Xylons/TFG_Francisco_de_la_Mata/README.md

# TFG_Francisco_de_la_Mata

Para ejecutar el insole-dashboard : ng serve

Para ejecutar el backend :  npm run start
