Xylons/TFG_Francisco_de_la_Mata/Proyecto_Android_low_powered_BLE_MAmIoT/Consumo/PCBV1/README.txt

PSOC Creator Configuration:

NOTE:Be careful with Time Scale.

VDD VDDR: 2.5V
Debug Select: GPIO
Heap:0x80
Stack Size 0x0800

Clocks:
IMO: 32Mhz
