Xylons/TFG_Francisco_de_la_Mata/Proyecto_Android_low_powered_BLE_MAmIoT/Notas.txt

Medir consumo/carga con INA
Volver a probar posibles interferencias.

Añadir diodo protector batería.
Cambiar fuente lineal por conmutada.
Buscar otro controlador batería.

Algoritmo de calibración.
