Xylons/TFG_Francisco_de_la_Mata/backend/images/admin-1592569588191.jpeg

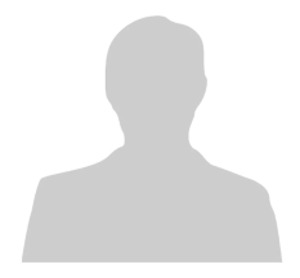
backend/images/admin-1592569588191.jpeg
