Xylons/TFG_Francisco_de_la_Mata/backend/images/marta-1599320887836.png

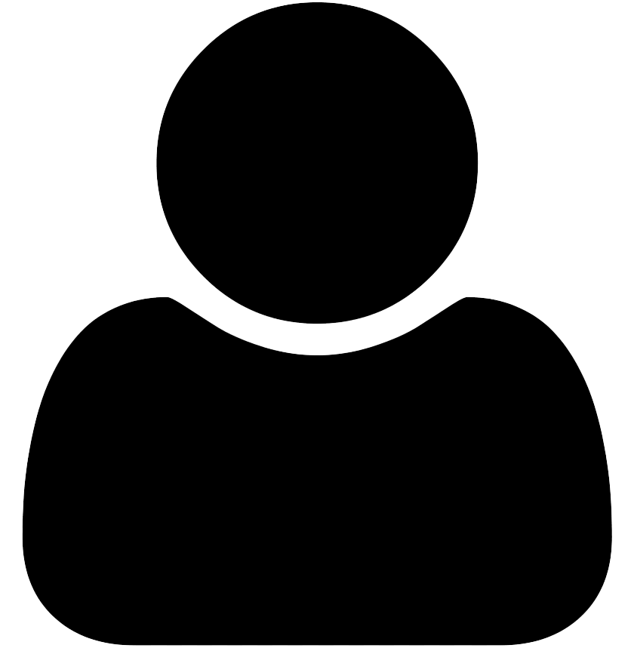
backend/images/marta-1599320887836.png
