Xylons/TFG_Francisco_de_la_Mata/backend/images/patient1-1595259013995.png

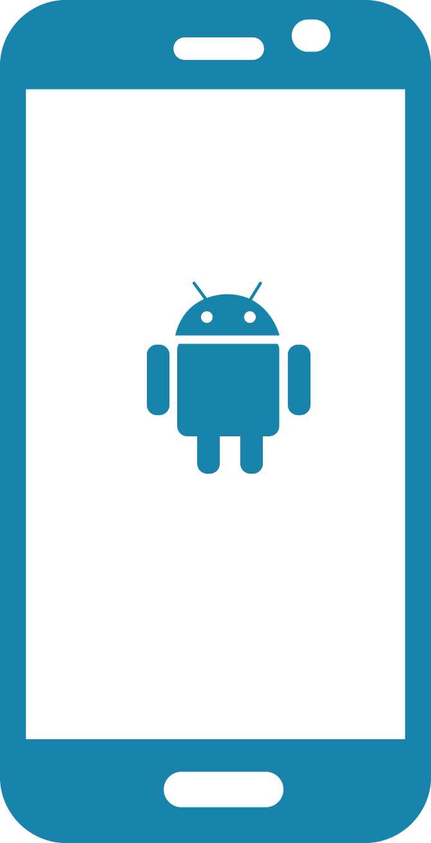
backend/images/patient1-1595259013995.png
