Xylons/TFG_Francisco_de_la_Mata/backend/images/saaaa-1586532342744.png

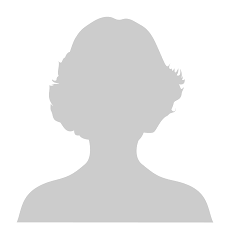
backend/images/saaaa-1586532342744.png
