Xylons/TFG_Francisco_de_la_Mata/Proyecto_Android_low_powered_BLE_MAmIoT/Consumo/Patrones/2.bmp

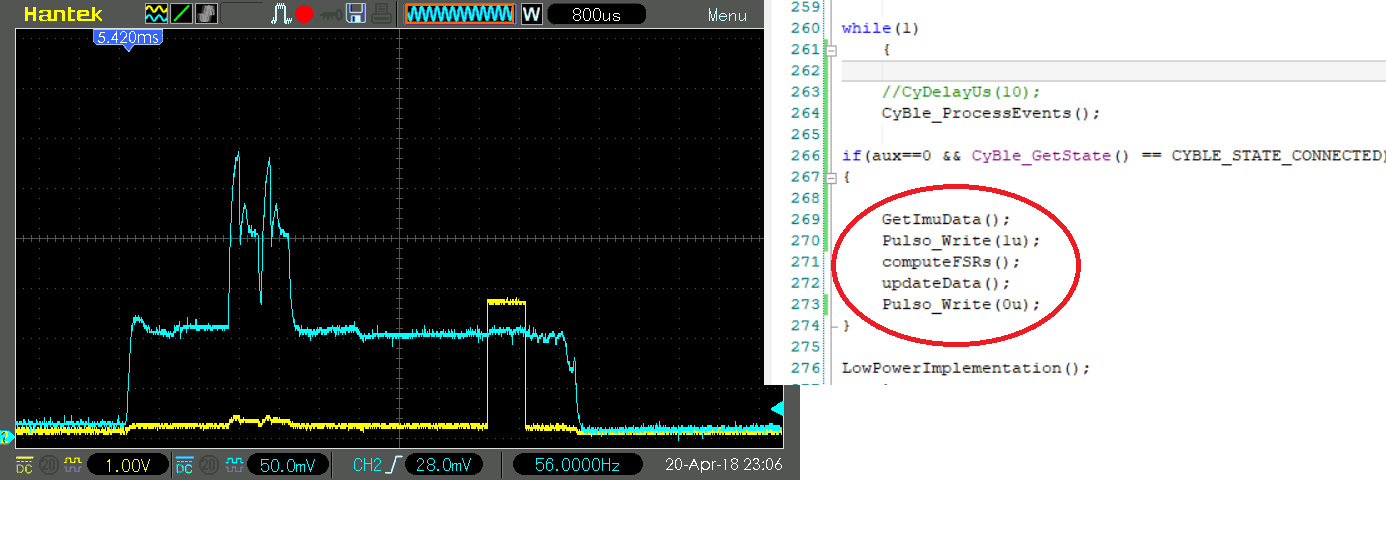
Proyecto_Android_low_powered_BLE_MAmIoT/Consumo/Patrones/2.bmp
