Xylons/TFG_Francisco_de_la_Mata/Proyecto_Android_low_powered_BLE_MAmIoT/Consumo/PCBV1/30Mhz/Low.bmp

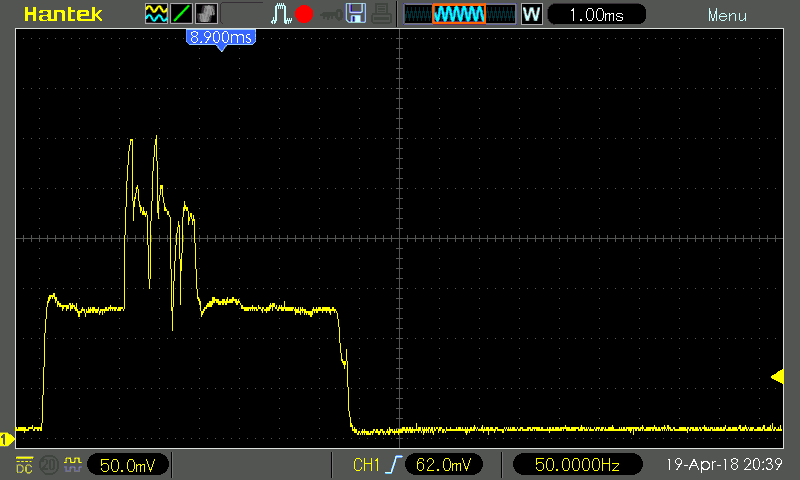
Proyecto_Android_low_powered_BLE_MAmIoT/Consumo/PCBV1/30Mhz/Low.bmp
