Xylons/TFG_Francisco_de_la_Mata/Proyecto_Android_low_powered_BLE_MAmIoT/Esquemas/updateInsole.png

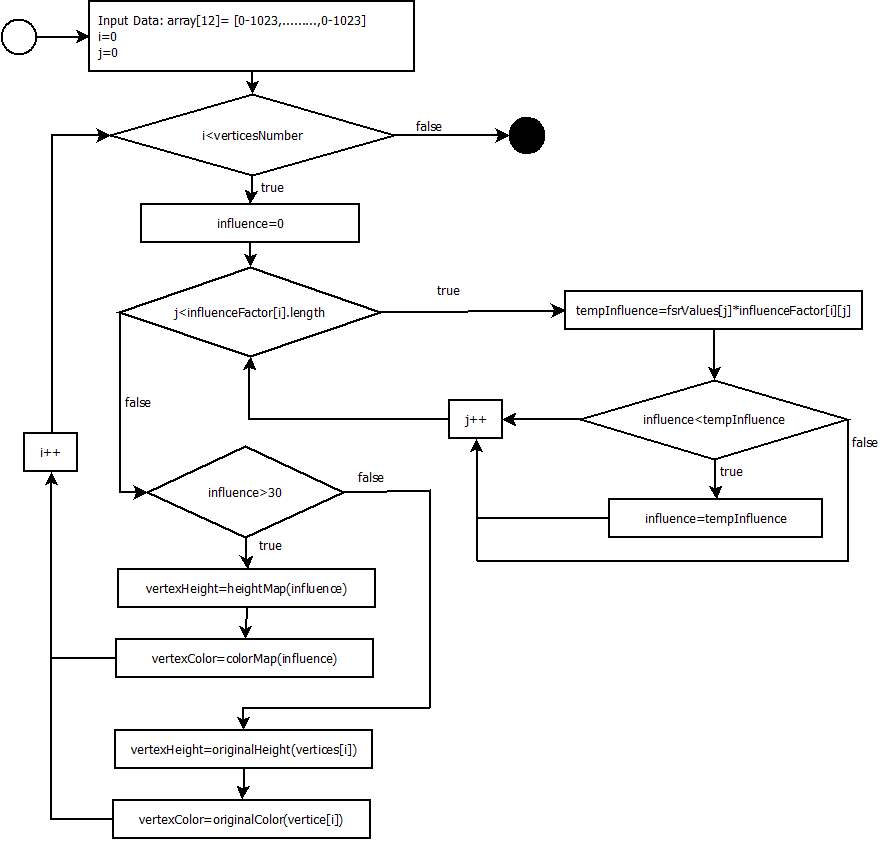
Proyecto_Android_low_powered_BLE_MAmIoT/Esquemas/updateInsole.png
