Xylons/TFG_Francisco_de_la_Mata/Proyecto_Android_low_powered_BLE_MAmIoT/FreeCad/Imagenes/parametros_configurables_lateral.png

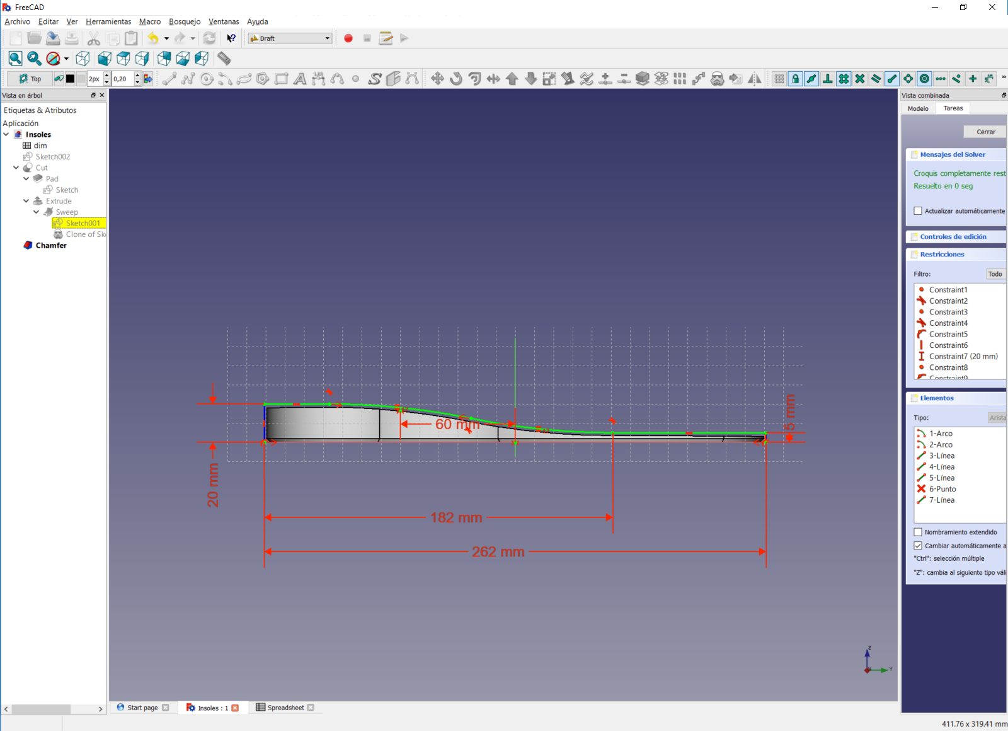
Proyecto_Android_low_powered_BLE_MAmIoT/FreeCad/Imagenes/parametros_configurables_lateral.png
