Xylons/TFG_Francisco_de_la_Mata/Proyecto_Android_low_powered_BLE_MAmIoT/FreeCad/Imagenes/plantilla_izq_y_drch.png

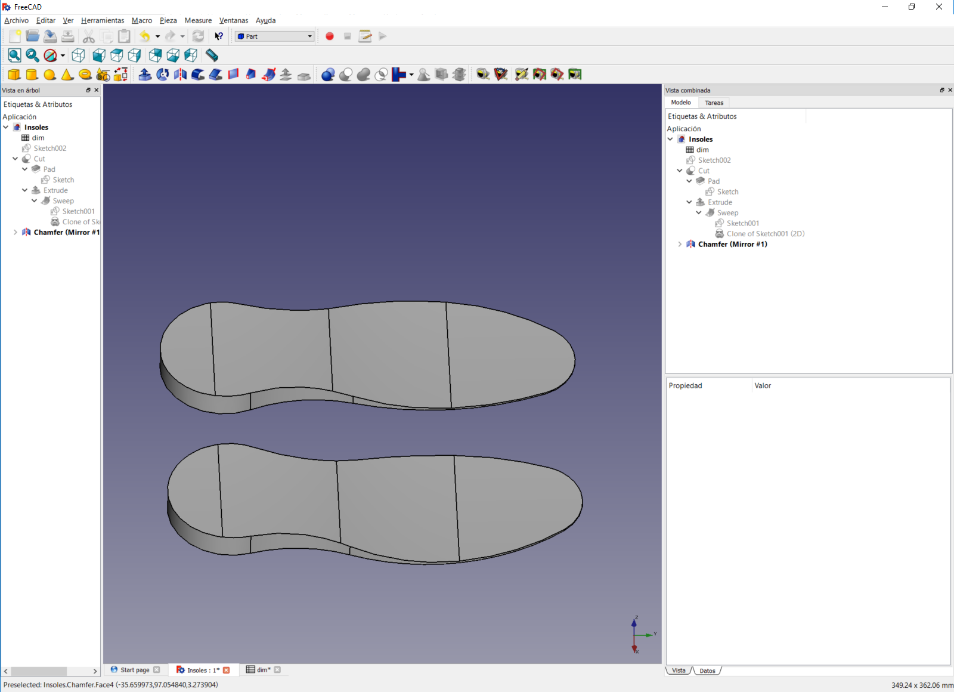
Proyecto_Android_low_powered_BLE_MAmIoT/FreeCad/Imagenes/plantilla_izq_y_drch.png
