Xylons/TFG_Francisco_de_la_Mata/Proyecto_Android_low_powered_BLE_MAmIoT/KiCad/Doc/FPC_Dimensions.jpg

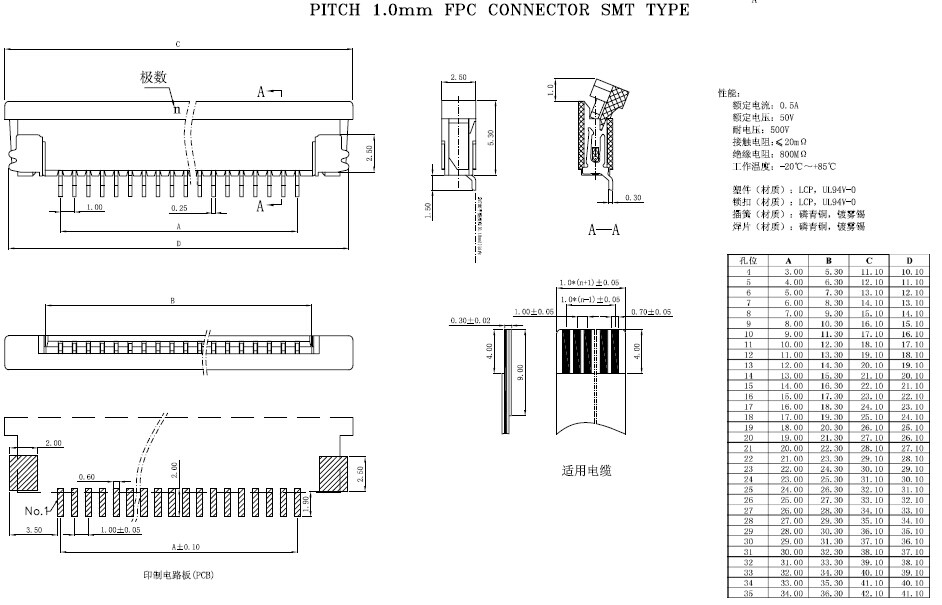
Proyecto_Android_low_powered_BLE_MAmIoT/KiCad/Doc/FPC_Dimensions.jpg
