Xylons/TFG_Francisco_de_la_Mata/Proyecto_Android_low_powered_BLE_MAmIoT/KiCad/Doc/MAmIoT_PCB.jpg

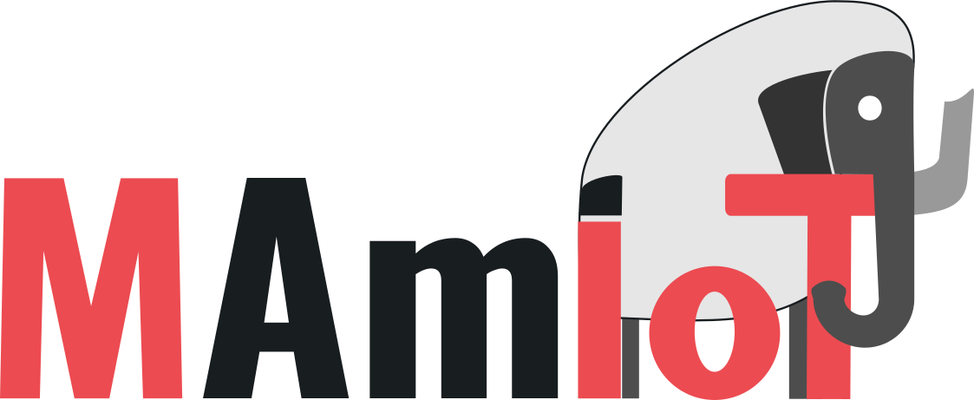
Proyecto_Android_low_powered_BLE_MAmIoT/KiCad/Doc/MAmIoT_PCB.jpg
