Xylons/TFG_Francisco_de_la_Mata/Proyecto_Android_low_powered_BLE_MAmIoT/KiCad/Insole_All_in_One/usb charger.png

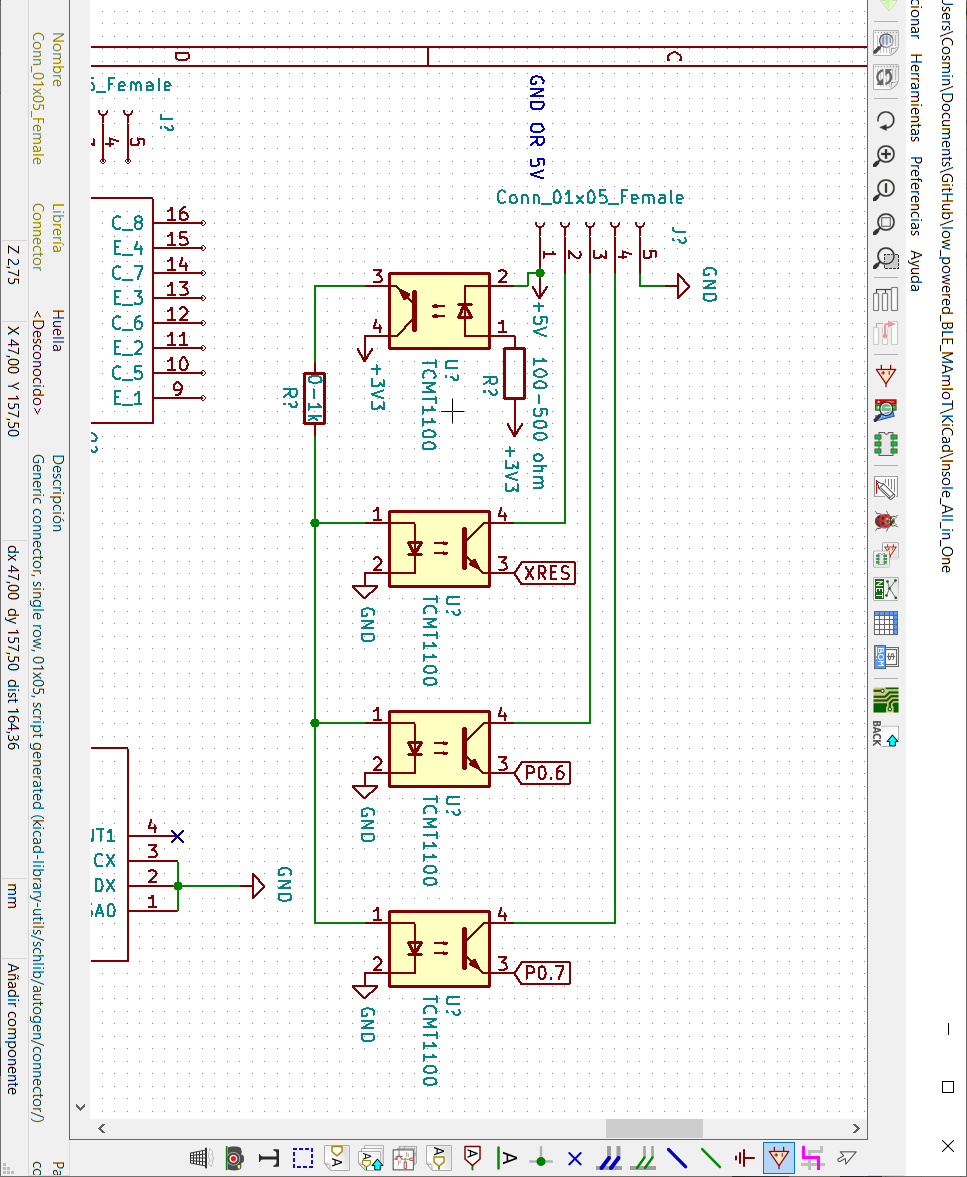
Proyecto_Android_low_powered_BLE_MAmIoT/KiCad/Insole_All_in_One/usb charger.png
