Xylons/TFG_Francisco_de_la_Mata/Proyecto_Android_low_powered_BLE_MAmIoT/KiCad/Doc/componentes_mejorados.txt

Fuente conmutada:
https://www.mouser.es/Semiconductors/Integrated-Circuits-ICs/Power-Management-ICs/Voltage-Regulators-Voltage-Controllers/Switching-Voltage-Regulators/_/N-6j76f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|0&No=25&P=1z0wa91Z1z0w87sZ1z0wcoiZ1z0w7yaZ1z0wbbzZ1z0w2k1Z1z0wcdhZ1z0wa2kZ1yzu4lsZ1z0z7ptZ1z0vne2Z1yutxogZ1yutx49Z1yxwtg1Z1z0vndnZ1y95l6b

Controladores de carga de bateria:
https://www.mouser.es/Semiconductors/Integrated-Circuits-ICs/Power-Management-ICs/Battery-Management/_/N-6j76v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

150mA : https://www.mouser.es/datasheet/2/277/MP2603_r1.01-371747.pdf
