Xylons/TFG_Francisco_de_la_Mata/Proyecto_Android_low_powered_BLE_MAmIoT/3DDesign/PiezoCeramicos/superior.stl

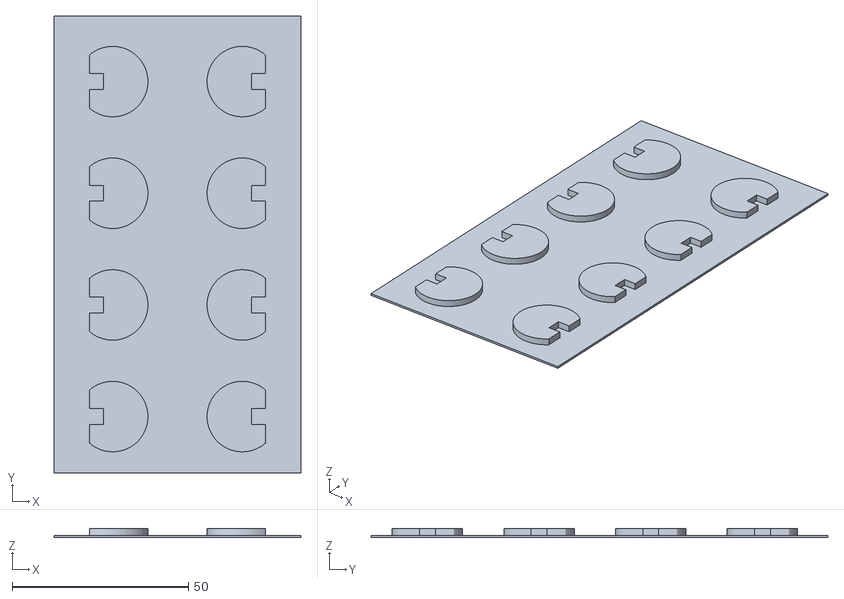
[picture p33: CAD file, 2020-07-15]
Proyecto_Android_low_powered_BLE_MAmIoT/3DDesign/PiezoCeramicos/superior.stl
70.0 x 129.6 x 2.60
