Xylons/TFG_Francisco_de_la_Mata/Proyecto_Android_low_powered_BLE_MAmIoT/3DDesign/suport.stl

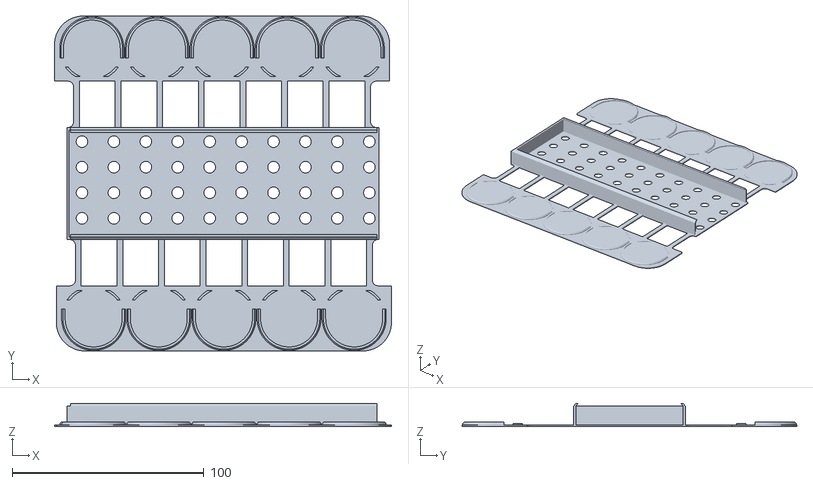
[picture p34: CAD file, 2020-07-15]
Proyecto_Android_low_powered_BLE_MAmIoT/3DDesign/suport.stl
176.0 x 174.9 x 12.2
