Xylons/TFG_Francisco_de_la_Mata/Proyecto_Android_low_powered_BLE_MAmIoT/FreeCad/FSRs/Parametric_square_fsr.FCStd

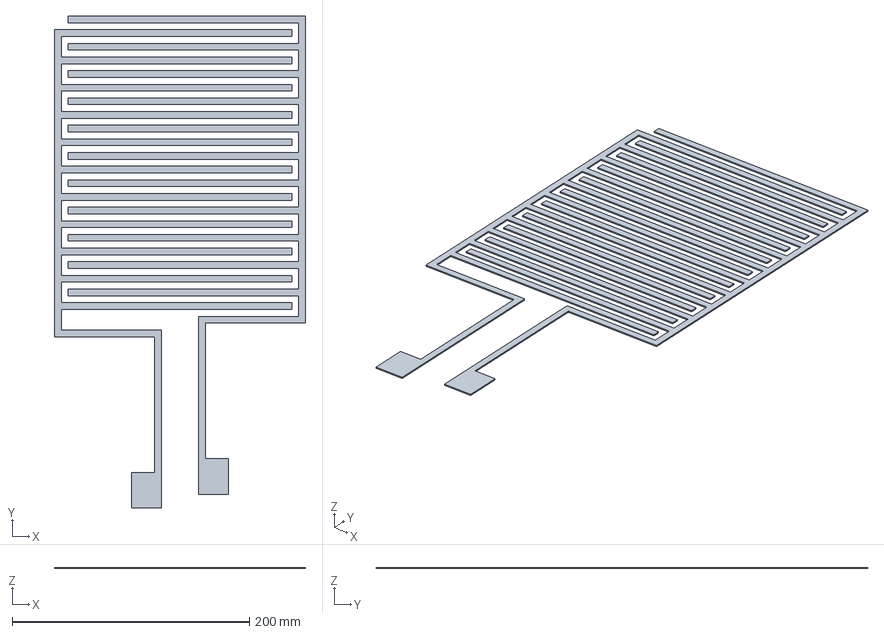
[picture p35: CAD file, 2020-07-15]
Proyecto_Android_low_powered_BLE_MAmIoT/FreeCad/FSRs/Parametric_square_fsr.FCStd
211.5 x 414.5 x 1.00 mm
