Xylons/TFG_Francisco_de_la_Mata/Proyecto_Android_low_powered_BLE_MAmIoT/FreeCad/InsoleV2/Parte_Inferior_derecha.stl

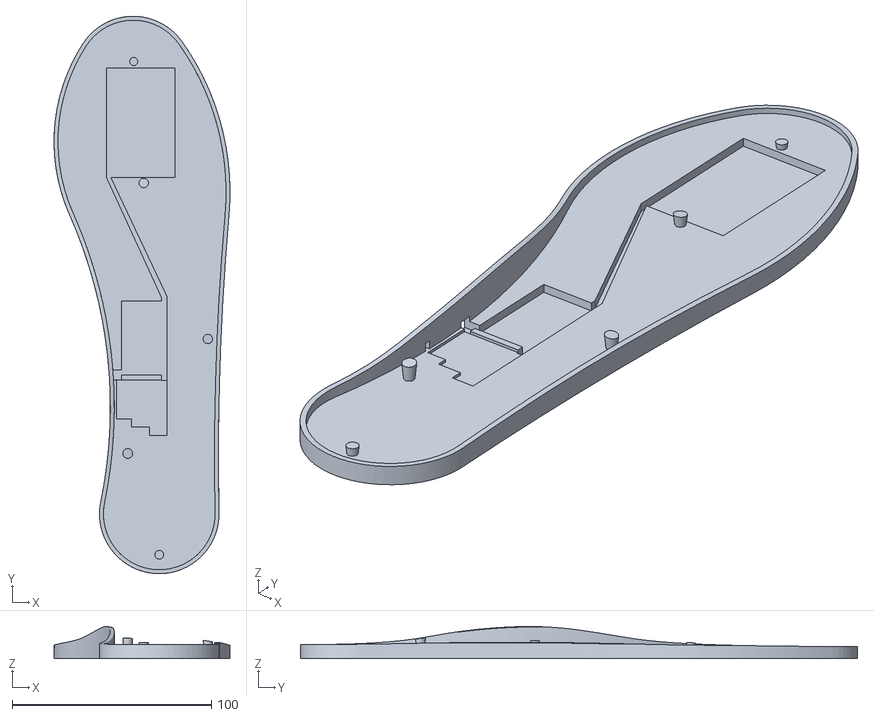
[picture p36: CAD file, 2020-07-15]
Proyecto_Android_low_powered_BLE_MAmIoT/FreeCad/InsoleV2/Parte_Inferior_derecha.stl
88.3 x 279.6 x 16.1
