Xylons/TFG_Francisco_de_la_Mata/Proyecto_Android_low_powered_BLE_MAmIoT/KiCad/Insole_All_in_One/plantillas/plantilla34.stl

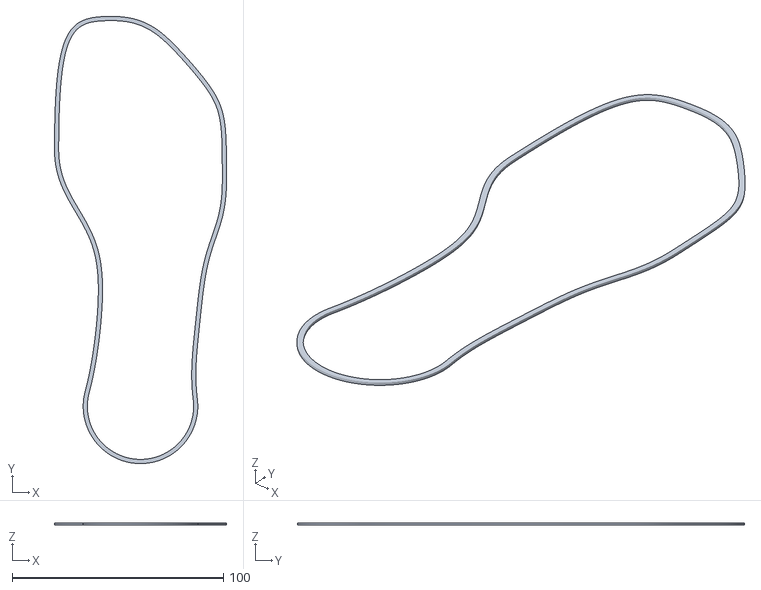
[picture p37: CAD file, 2020-07-15]
Proyecto_Android_low_powered_BLE_MAmIoT/KiCad/Insole_All_in_One/plantillas/plantilla34.stl
81.4 x 211.7 x 1.00
