Xylons/TFG_Francisco_de_la_Mata/Proyecto_Android_low_powered_BLE_MAmIoT/KiCad/Insole_All_in_One_43/plantillas/plantilla34_offset.dxf

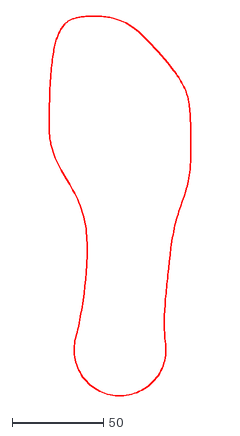
[picture p38: CAD file, 2020-07-15]
Proyecto_Android_low_powered_BLE_MAmIoT/KiCad/Insole_All_in_One_43/plantillas/plantilla34_offset.dxf
77.4 x 207.7
