Xylons/TFG_Francisco_de_la_Mata/Proyecto_Android_low_powered_BLE_MAmIoT/KiCad/Insole_flex_left_32_sensors_right/fabrication/Insole_flex_32s-Edge.Cuts.dxf

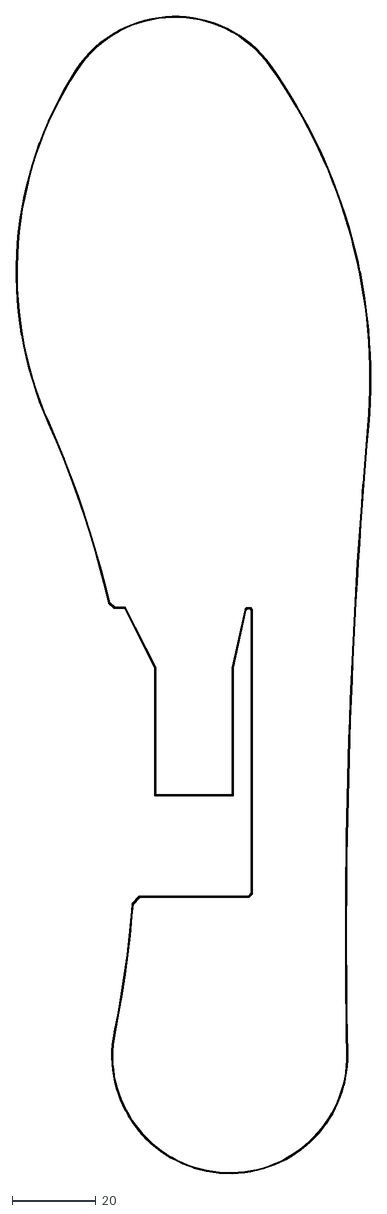
[picture p39: CAD file, 2020-07-15]
Proyecto_Android_low_powered_BLE_MAmIoT/KiCad/Insole_flex_left_32_sensors_right/fabrication/Insole_flex_32s-Edge.Cuts.dxf
84.5 x 275.8
