Xylons/TFG_Francisco_de_la_Mata/Proyecto_Android_low_powered_BLE_MAmIoT/KiCad/Insole_PCB_production_32_sensors/fabrication/fabricacion_dxf/Insole_PCB-F.Cu.dxf

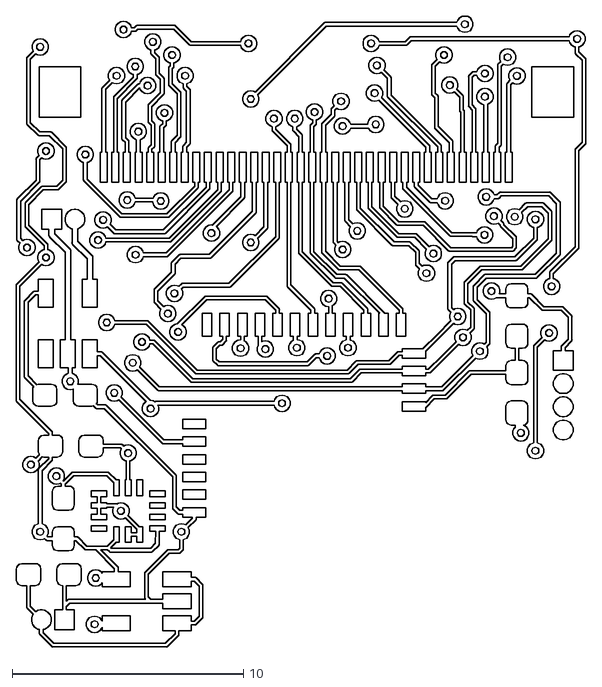
[picture p40: CAD file, 2020-07-15]
Proyecto_Android_low_powered_BLE_MAmIoT/KiCad/Insole_PCB_production_32_sensors/fabrication/fabricacion_dxf/Insole_PCB-F.Cu.dxf
24.6 x 27.3
