Xylons/TFG_Francisco_de_la_Mata/Proyecto_Android_low_powered_BLE_MAmIoT/KiCad/Prototypes_06_01_2020/Insole_All_in_One_37/plantillas/plantilla43_exterior.dxf

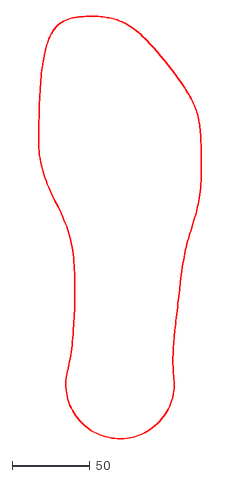
[picture p41: CAD file, 2020-07-15]
Proyecto_Android_low_powered_BLE_MAmIoT/KiCad/Prototypes_06_01_2020/Insole_All_in_One_37/plantillas/plantilla43_exterior.dxf
104.5 x 271.7
