Xylons/TFG_Francisco_de_la_Mata/Proyecto_Android_low_powered_BLE_MAmIoT/KiCad/Prototypes_06_01_2020/Insole_All_in_One_38/plantillas/insole43.stl

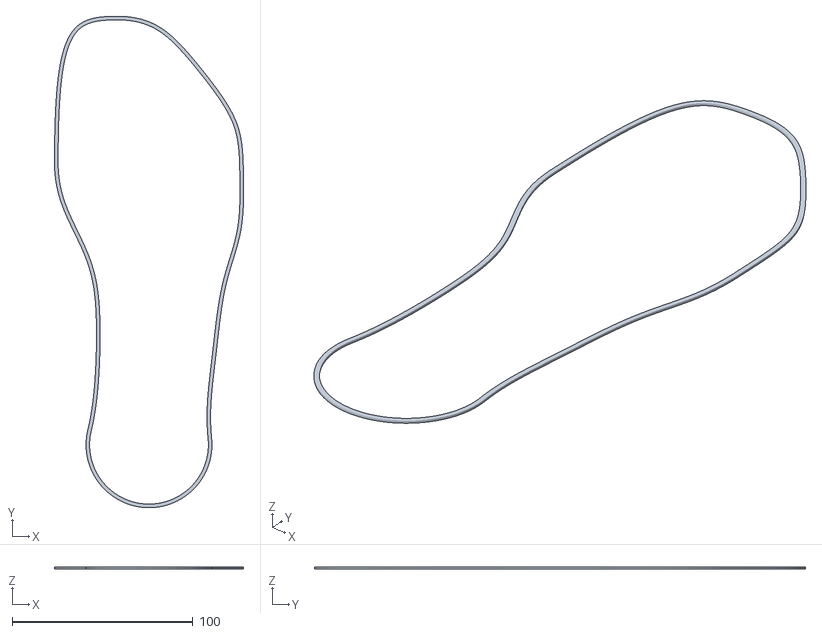
[picture p42: CAD file, 2020-07-15]
Proyecto_Android_low_powered_BLE_MAmIoT/KiCad/Prototypes_06_01_2020/Insole_All_in_One_38/plantillas/insole43.stl
104.5 x 271.7 x 1.00
