Xylons/TFG_Francisco_de_la_Mata/Proyecto_Android_low_powered_BLE_MAmIoT/KiCad/Prototypes_06_01_2020/Insole_All_in_One_43/plantillas/plantilla43_interior.dxf

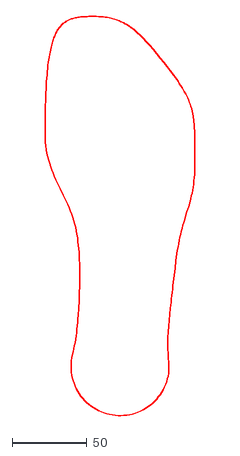
[picture p43: CAD file, 2020-07-15]
Proyecto_Android_low_powered_BLE_MAmIoT/KiCad/Prototypes_06_01_2020/Insole_All_in_One_43/plantillas/plantilla43_interior.dxf
100.5 x 267.7
