Xylons/TFG_Francisco_de_la_Mata/Proyecto_Android_low_powered_BLE_MAmIoT/KiCad/Prototypes_06_01_2020/Modelo_Plantilla40_Interior.dxf

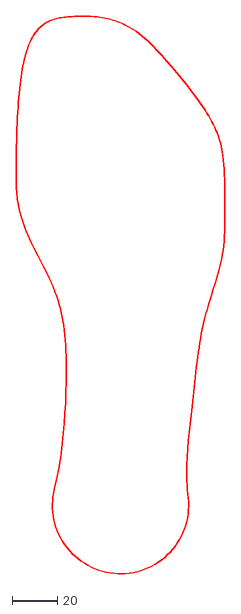
[picture p44: CAD file, 2020-07-15]
Proyecto_Android_low_powered_BLE_MAmIoT/KiCad/Prototypes_06_01_2020/Modelo_Plantilla40_Interior.dxf
92.8 x 247.7
