Xylons/TFG_Francisco_de_la_Mata/Proyecto_Android_low_powered_BLE_MAmIoT/FreeCad/FSRs/montaje.FCStd

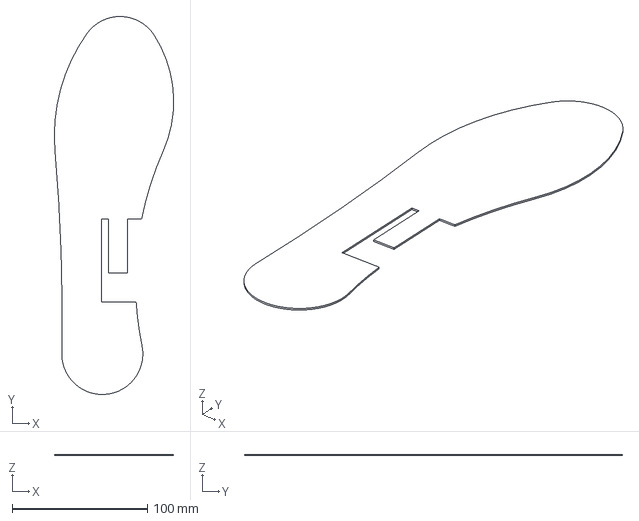
[picture p46: CAD file, 2020-07-15]
Proyecto_Android_low_powered_BLE_MAmIoT/FreeCad/FSRs/montaje.FCStd
88.3 x 279.6 x 1.00 mm
