Xylons/TFG_Francisco_de_la_Mata/Proyecto_Android_low_powered_BLE_MAmIoT/FreeCad/InsoleV2/tapa_carga_inalambrica_derecha.stl

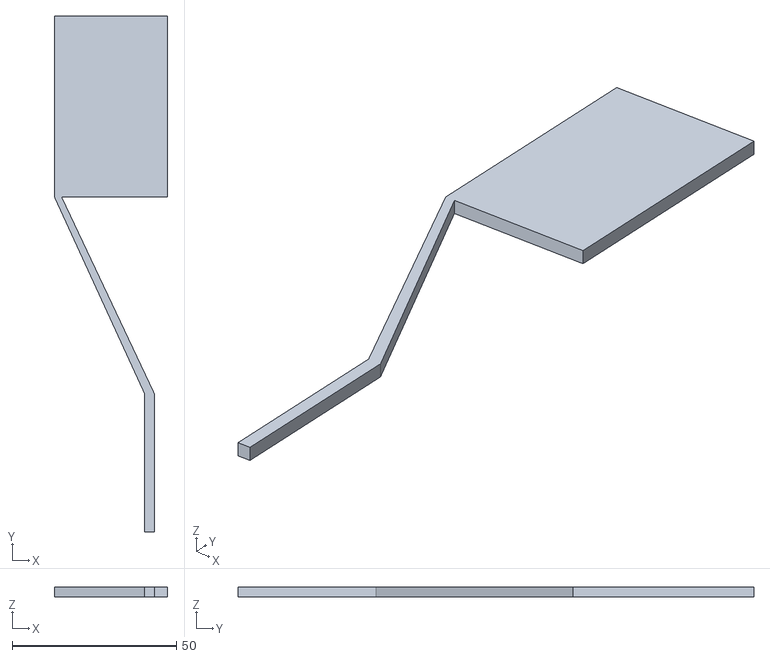
[picture p47: CAD file, 2020-07-15]
Proyecto_Android_low_powered_BLE_MAmIoT/FreeCad/InsoleV2/tapa_carga_inalambrica_derecha.stl
34.5 x 157.0 x 3.00
