Xylons/TFG_Francisco_de_la_Mata/Proyecto_Android_low_powered_BLE_MAmIoT/KiCad/Insole_PCB_production_32_sensors/fabrication/fabricacion_dxf/Insole_PCB-Edge.Cuts.dxf

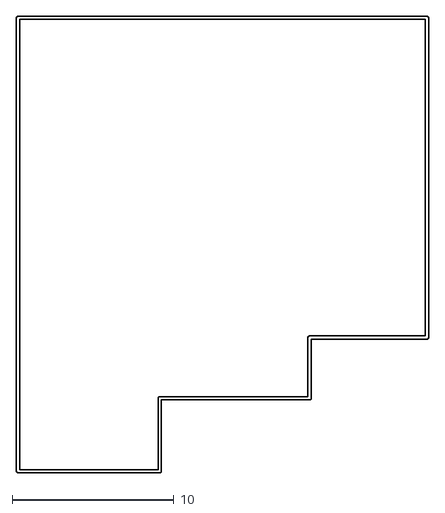
[picture p48: CAD file, 2020-07-15]
Proyecto_Android_low_powered_BLE_MAmIoT/KiCad/Insole_PCB_production_32_sensors/fabrication/fabricacion_dxf/Insole_PCB-Edge.Cuts.dxf
25.4 x 28.2
