Xylons/TFG_Francisco_de_la_Mata/Proyecto_Android_low_powered_BLE_MAmIoT/KiCad/Prototypes_06_01_2020/Modelo_Plantilla36.stl

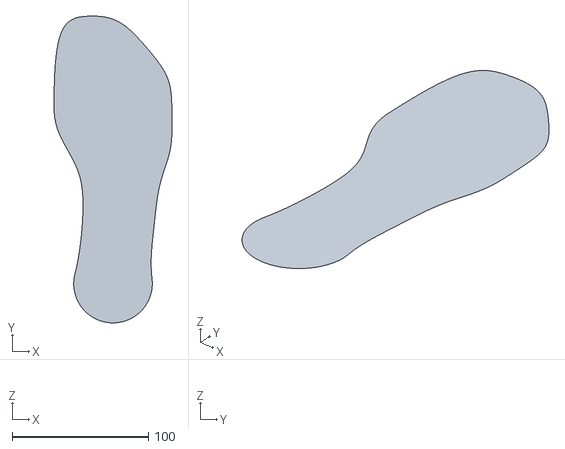
[picture p49: CAD file, 2020-07-15]
Proyecto_Android_low_powered_BLE_MAmIoT/KiCad/Prototypes_06_01_2020/Modelo_Plantilla36.stl
86.5 x 225.0 x 0
