Xylons/TFG_Francisco_de_la_Mata/Proyecto_Android_low_powered_BLE_MAmIoT/3DDesign/PiezoCeramicos/inferior.stl

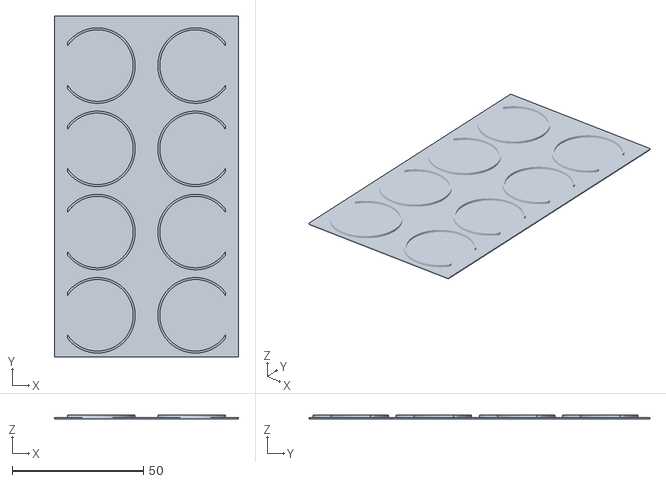
[picture p50: CAD file, 2020-07-15]
Proyecto_Android_low_powered_BLE_MAmIoT/3DDesign/PiezoCeramicos/inferior.stl
70.0 x 129.6 x 1.60
