Xylons/TFG_Francisco_de_la_Mata/Proyecto_Android_low_powered_BLE_MAmIoT/FreeCad/InsoleV2/Insole_protect_QI_Charge.FCStd

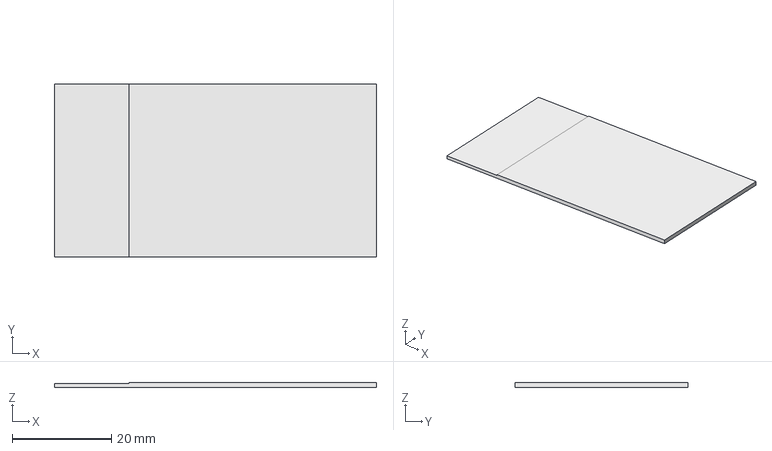
[picture p51: CAD file, 2020-07-15]
Proyecto_Android_low_powered_BLE_MAmIoT/FreeCad/InsoleV2/Insole_protect_QI_Charge.FCStd
65.0 x 35.0 x 1.00 mm
