Xylons/TFG_Francisco_de_la_Mata/Proyecto_Android_low_powered_BLE_MAmIoT/KiCad/Insole_PCB_production_32_sensors/fabrication/fabricacion_dxf/Insole_PCB-B.Cu.dxf

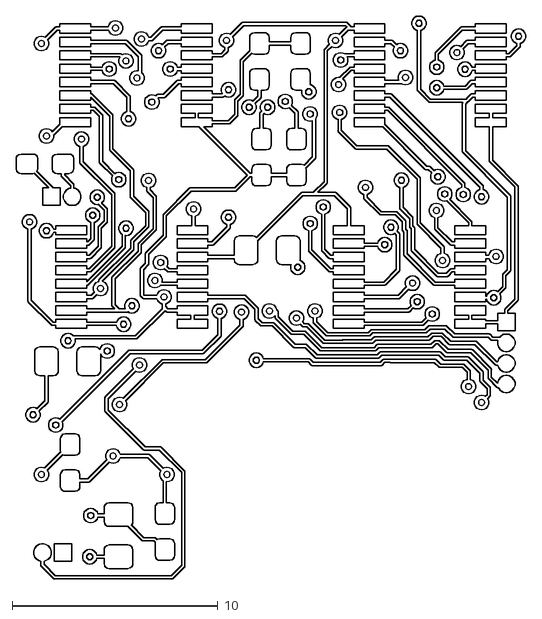
[picture p52: CAD file, 2020-07-15]
Proyecto_Android_low_powered_BLE_MAmIoT/KiCad/Insole_PCB_production_32_sensors/fabrication/fabricacion_dxf/Insole_PCB-B.Cu.dxf
24.8 x 27.4
