Xylons/TFG_Francisco_de_la_Mata/Proyecto_Android_low_powered_BLE_MAmIoT/KiCad/Prototypes_06_01_2020/Modelo_Plantilla38_Interior.dxf

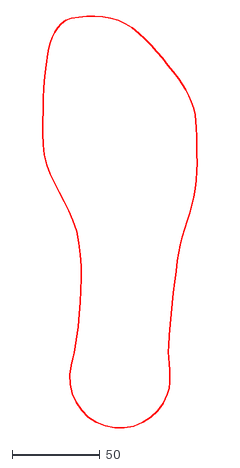
[picture p53: CAD file, 2020-07-15]
Proyecto_Android_low_powered_BLE_MAmIoT/KiCad/Prototypes_06_01_2020/Modelo_Plantilla38_Interior.dxf
87.7 x 234.3
