Xylons/TFG_Francisco_de_la_Mata/Proyecto_Android_low_powered_BLE_MAmIoT/KiCad/Prototypes_06_01_2020/Modelo_Plantilla40_Exterior.dxf

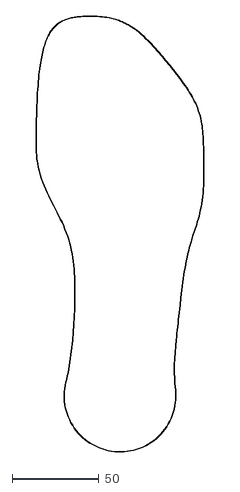
[picture p54: CAD file, 2020-07-15]
Proyecto_Android_low_powered_BLE_MAmIoT/KiCad/Prototypes_06_01_2020/Modelo_Plantilla40_Exterior.dxf
96.8 x 251.7
