Xylons/TFG_Francisco_de_la_Mata/Proyecto_Android_low_powered_BLE_MAmIoT/FreeCad/InsoleV2/Parte_Superior.stl

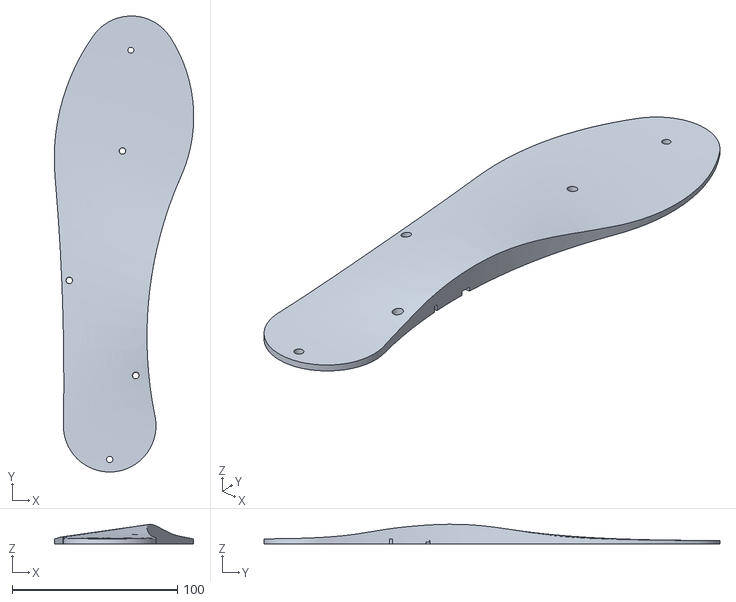
[picture p55: CAD file, 2020-07-15]
Proyecto_Android_low_powered_BLE_MAmIoT/FreeCad/InsoleV2/Parte_Superior.stl
84.3 x 275.6 x 11.8
