Xylons/TFG_Francisco_de_la_Mata/Proyecto_Android_low_powered_BLE_MAmIoT/FreeCad/InsoleV2/Insoles.FCStd

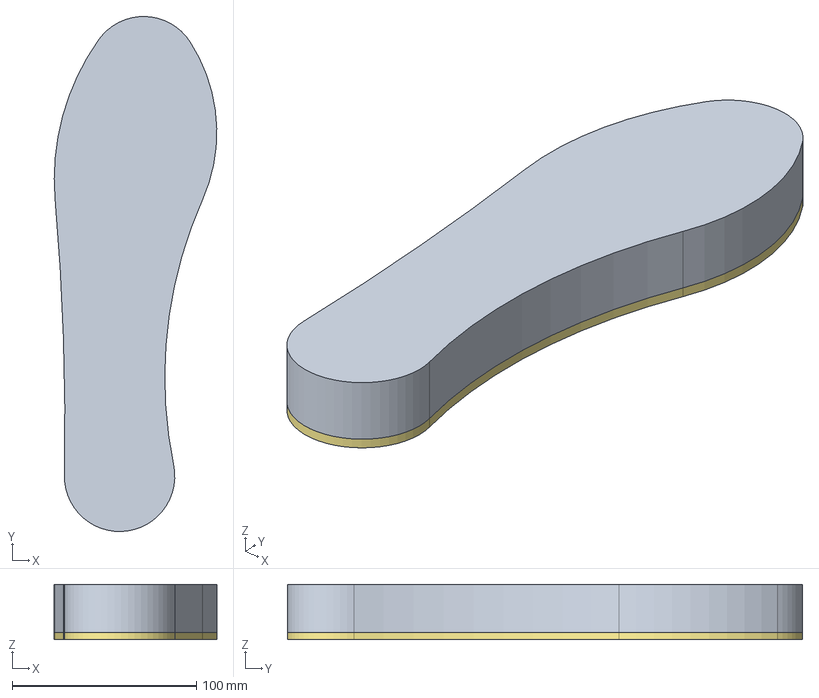
[picture p57: CAD file, 2020-07-15]
Proyecto_Android_low_powered_BLE_MAmIoT/FreeCad/InsoleV2/Insoles.FCStd
88.3 x 279.6 x 30.0 mm
Body_Base3D
Body_Pirulo1
Body_Pirulo2
Body_Pirulo3
Body_Pirulo4
Body_Pirulo5
Parte_Inferior_Plantilla
Pad003Body
