Xylons/TFG_Francisco_de_la_Mata/(list of files, cad)

Other CAD files:
Proyecto_Android_low_powered_BLE_MAmIoT/FreeCad/pieza_filaflex/filaflex.FCStd
Proyecto_Android_low_powered_BLE_MAmIoT/FreeCad/test_PCB/test_1.FCStd
Proyecto_Android_low_powered_BLE_MAmIoT/3DDesign/sujecionFSR.FCStd
Proyecto_Android_low_powered_BLE_MAmIoT/FreeCad/InsoleV2/Parte_Inferior.stl
Proyecto_Android_low_powered_BLE_MAmIoT/FreeCad/InsoleV2/Parte_Superior_Derecha.stl
Proyecto_Android_low_powered_BLE_MAmIoT/FreeCad/InsoleV2/tapa_carga_inalambrica.stl
Proyecto_Android_low_powered_BLE_MAmIoT/Blender/insole_left.blend
Proyecto_Android_low_powered_BLE_MAmIoT/Blender/insole_left_surface.blend
Proyecto_Android_low_powered_BLE_MAmIoT/Blender/insole_right.blend
Proyecto_Android_low_powered_BLE_MAmIoT/Blender/insole_right_surface.blend
Proyecto_Android_low_powered_BLE_MAmIoT/FreeCad/InsoleV1/Insoles.FCStd
Proyecto_Android_low_powered_BLE_MAmIoT/FreeCad/InsoleV1/PCB_SUPPORT_PERIMETER.stl
Proyecto_Android_low_powered_BLE_MAmIoT/FreeCad/InsoleV1/PCB_SUPPORT_PERIMETERç.FCStd
Proyecto_Android_low_powered_BLE_MAmIoT/FreeCad/InsoleV1/PCB_Support_for_stencils.FCStd
Proyecto_Android_low_powered_BLE_MAmIoT/FreeCad/InsoleV1/PCB_Support_for_stencils.stl
Proyecto_Android_low_powered_BLE_MAmIoT/FreeCad/InsoleV1/Solder_Paste_card.FCStd
Proyecto_Android_low_powered_BLE_MAmIoT/FreeCad/InsoleV1/Solder_Paste_card.stl
Proyecto_Android_low_powered_BLE_MAmIoT/FreeCad/InsoleV1/insole_left.obj
Proyecto_Android_low_powered_BLE_MAmIoT/FreeCad/InsoleV1/insole_left.step
Proyecto_Android_low_powered_BLE_MAmIoT/FreeCad/InsoleV1/insole_left.stl
Proyecto_Android_low_powered_BLE_MAmIoT/FreeCad/InsoleV1/kicad-2mm.dxf
Proyecto_Android_low_powered_BLE_MAmIoT/FreeCad/InsoleV1/kicad.dxf
Proyecto_Android_low_powered_BLE_MAmIoT/FreeCad/InsoleV1/kicad_95.dxf
Proyecto_Android_low_powered_BLE_MAmIoT/FreeCad/InsoleV1/v1.0.stl
Proyecto_Android_low_powered_BLE_MAmIoT/InsoleV2/app/src/main/assets/derecha.blend
Proyecto_Android_low_powered_BLE_MAmIoT/InsoleV2/app/src/main/assets/derecha_superficie.blend
Proyecto_Android_low_powered_BLE_MAmIoT/InsoleV2/app/src/main/assets/izquierda.blend
Proyecto_Android_low_powered_BLE_MAmIoT/InsoleV2/app/src/main/assets/izquierda_surface.blend
Proyecto_Android_low_powered_BLE_MAmIoT/KiCad/Insole_All_in_One/plantillas/plantilla34.dxf
Proyecto_Android_low_powered_BLE_MAmIoT/KiCad/Insole_All_in_One_43/plantillas/plantilla34.dxf
Proyecto_Android_low_powered_BLE_MAmIoT/KiCad/Insole_All_in_One_43_Left/plantillas/plantilla34.dxf
Proyecto_Android_low_powered_BLE_MAmIoT/KiCad/Insole_All_in_One_43_Left_old_usb/plantillas/plantilla34.dxf
Proyecto_Android_low_powered_BLE_MAmIoT/KiCad/Insole_PCB_production_32_sensors/fabrication/fabricacion_dxf/Insole_PCB-B.Mask.dxf
Proyecto_Android_low_powered_BLE_MAmIoT/KiCad/Insole_PCB_production_32_sensors/fabrication/fabricacion_dxf/Insole_PCB-B.SilkS.dxf
Proyecto_Android_low_powered_BLE_MAmIoT/KiCad/Insole_PCB_production_32_sensors/fabrication/fabricacion_dxf/Insole_PCB-F.Mask.dxf
Proyecto_Android_low_powered_BLE_MAmIoT/KiCad/Insole_PCB_production_32_sensors/fabrication/fabricacion_dxf/Insole_PCB-F.SilkS.dxf
Proyecto_Android_low_powered_BLE_MAmIoT/KiCad/Insole_flex_left_32_sensors_right/fabrication/Insole_flex_32s-F.Mask.dxf
Proyecto_Android_low_powered_BLE_MAmIoT/KiCad/Prototypes_06_01_2020/Insole_All_in_One_36/plantillas/plantilla34.dxf
Proyecto_Android_low_powered_BLE_MAmIoT/KiCad/Prototypes_06_01_2020/Insole_All_in_One_36_LEFT/plantillas/plantilla34.dxf
Proyecto_Android_low_powered_BLE_MAmIoT/KiCad/Prototypes_06_01_2020/Insole_All_in_One_37/plantillas/plantilla34.dxf
Proyecto_Android_low_powered_BLE_MAmIoT/KiCad/Prototypes_06_01_2020/Insole_All_in_One_37_LEFT/plantillas/plantilla34.dxf
Proyecto_Android_low_powered_BLE_MAmIoT/KiCad/Prototypes_06_01_2020/Insole_All_in_One_38/plantillas/plantilla34.dxf
Proyecto_Android_low_powered_BLE_MAmIoT/KiCad/Prototypes_06_01_2020/Insole_All_in_One_38_LEFT/plantillas/plantilla34.dxf
Proyecto_Android_low_powered_BLE_MAmIoT/KiCad/Prototypes_06_01_2020/Insole_All_in_One_40/plantillas/plantilla34.dxf
Proyecto_Android_low_powered_BLE_MAmIoT/KiCad/Prototypes_06_01_2020/Insole_All_in_One_40_LEFT/plantillas/plantilla34.dxf
Proyecto_Android_low_powered_BLE_MAmIoT/KiCad/Prototypes_06_01_2020/Insole_All_in_One_43/plantillas/plantilla34.dxf
Proyecto_Android_low_powered_BLE_MAmIoT/KiCad/Prototypes_06_01_2020/Insole_All_in_One_43_LEFT/plantillas/plantilla34.dxf
Proyecto_Android_low_powered_BLE_MAmIoT/KiCad/Prototypes_06_01_2020/Modelo_Plantilla40.dxf
Proyecto_Android_low_powered_BLE_MAmIoT/KiCad/Prototypes_06_01_2020/OLD_29_01_2020_Left/Insole_All_in_One_36_LEFT/plantillas/plantilla34.dxf
Proyecto_Android_low_powered_BLE_MAmIoT/KiCad/Prototypes_06_01_2020/OLD_29_01_2020_Left/Insole_All_in_One_37_LEFT/plantillas/plantilla34.dxf
Proyecto_Android_low_powered_BLE_MAmIoT/KiCad/Prototypes_06_01_2020/OLD_29_01_2020_Left/Insole_All_in_One_38_LEFT/plantillas/plantilla34.dxf
Proyecto_Android_low_powered_BLE_MAmIoT/KiCad/Prototypes_06_01_2020/OLD_29_01_2020_Left/Insole_All_in_One_40_LEFT/plantillas/plantilla34.dxf
Proyecto_Android_low_powered_BLE_MAmIoT/KiCad/Prototypes_06_01_2020/OLD_29_01_2020_Left/Insole_All_in_One_43_LEFT/plantillas/plantilla34.dxf
Proyecto_Android_low_powered_BLE_MAmIoT/KiCad/Prototypes_06_01_2020/OLD_Left/Insole_All_in_One_36_Left/plantillas/plantilla34.dxf
Proyecto_Android_low_powered_BLE_MAmIoT/KiCad/Prototypes_06_01_2020/OLD_Left/Insole_All_in_One_37_Left/plantillas/plantilla34.dxf
Proyecto_Android_low_powered_BLE_MAmIoT/KiCad/Prototypes_06_01_2020/OLD_Left/Insole_All_in_One_38_Left/plantillas/plantilla34.dxf
Proyecto_Android_low_powered_BLE_MAmIoT/KiCad/Prototypes_06_01_2020/OLD_Left/Insole_All_in_One_40_Left/plantillas/plantilla34.dxf
Proyecto_Android_low_powered_BLE_MAmIoT/KiCad/Prototypes_06_01_2020/OLD_Left/Insole_All_in_One_43_Left/plantillas/plantilla34.dxf
