Xylons/TFG_Francisco_de_la_Mata/Proyecto_Android_low_powered_BLE_MAmIoT/Consumo/PCBV1_Firmware_Repaired/Measuring_BLE_Power_Consumption.xls

 | Battery capacity : | 250 | mAh
 | Frequency: | 50 | Hz
 | Deep Sleep Current | 0.2 | mA
 | Battery correction factor: | 0.8
 |  | 16MHz |  |  | 22MHz |  |  | 30MHz
 |  | Time (us) | Current (mA) | Time*Current | Time (us) | Current (mA) | Time*Current | Time (us) | Current (mA) | Time*Current
State 1 | wake-up | 1000 | 10 | 10000 | 1000 | 11 | 11000 | 1000 | 13.5 | 13500
State 2 | pre-processing | 1000 | 10 | 10000 | 1000 | 11 | 11000 | 1000 | 13.5 | 13500
State 3 | Rx | 180 | 26 | 4680 | 200 | 27 | 5400 | 400 | 29.5 | 11800
 |  | 100 | 21 | 2100 | 200 | 21.5 | 4300 | 200 | 24 | 4800
State 4 | Rx-to-Tx | 210 | 17 | 3570 | 300 | 18 | 5400 | 200 | 21 | 4200
State 5 | Tx | 190 | 24 | 4560 | 300 | 24.5 | 7350 | 200 | 28 | 5600
 |  | 400 | 20 | 8000 | 0 | 0 | 0 | 390 | 22 | 8580
State 6 | post-processing | 5600 | 9 | 50400 | 1000 | 14 | 14000 | 4400 | 13 | 57200
 |  | 1200 | 8 | 9600 | 4000 | 10 | 40000 | 200 | 5 | 1000
 |  | 0 | 0 | 0 | 0 | 0 | 0 | 0 | 0 | 0
State 7 | pre-sleep | 500 | 4 | 2000 | 1200 | 5 | 6000 | 0 | 0 | 0
 |  |  |  | 104910 |  |  | 104450 |  |  | 120180
 | Total event time | 10380 |  |  | 9200 |  |  | 7990
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
