Xylons/TFG_Francisco_de_la_Mata/Proyecto_Android_low_powered_BLE_MAmIoT/Esquemas/esquema_ahorro_energia.pdf

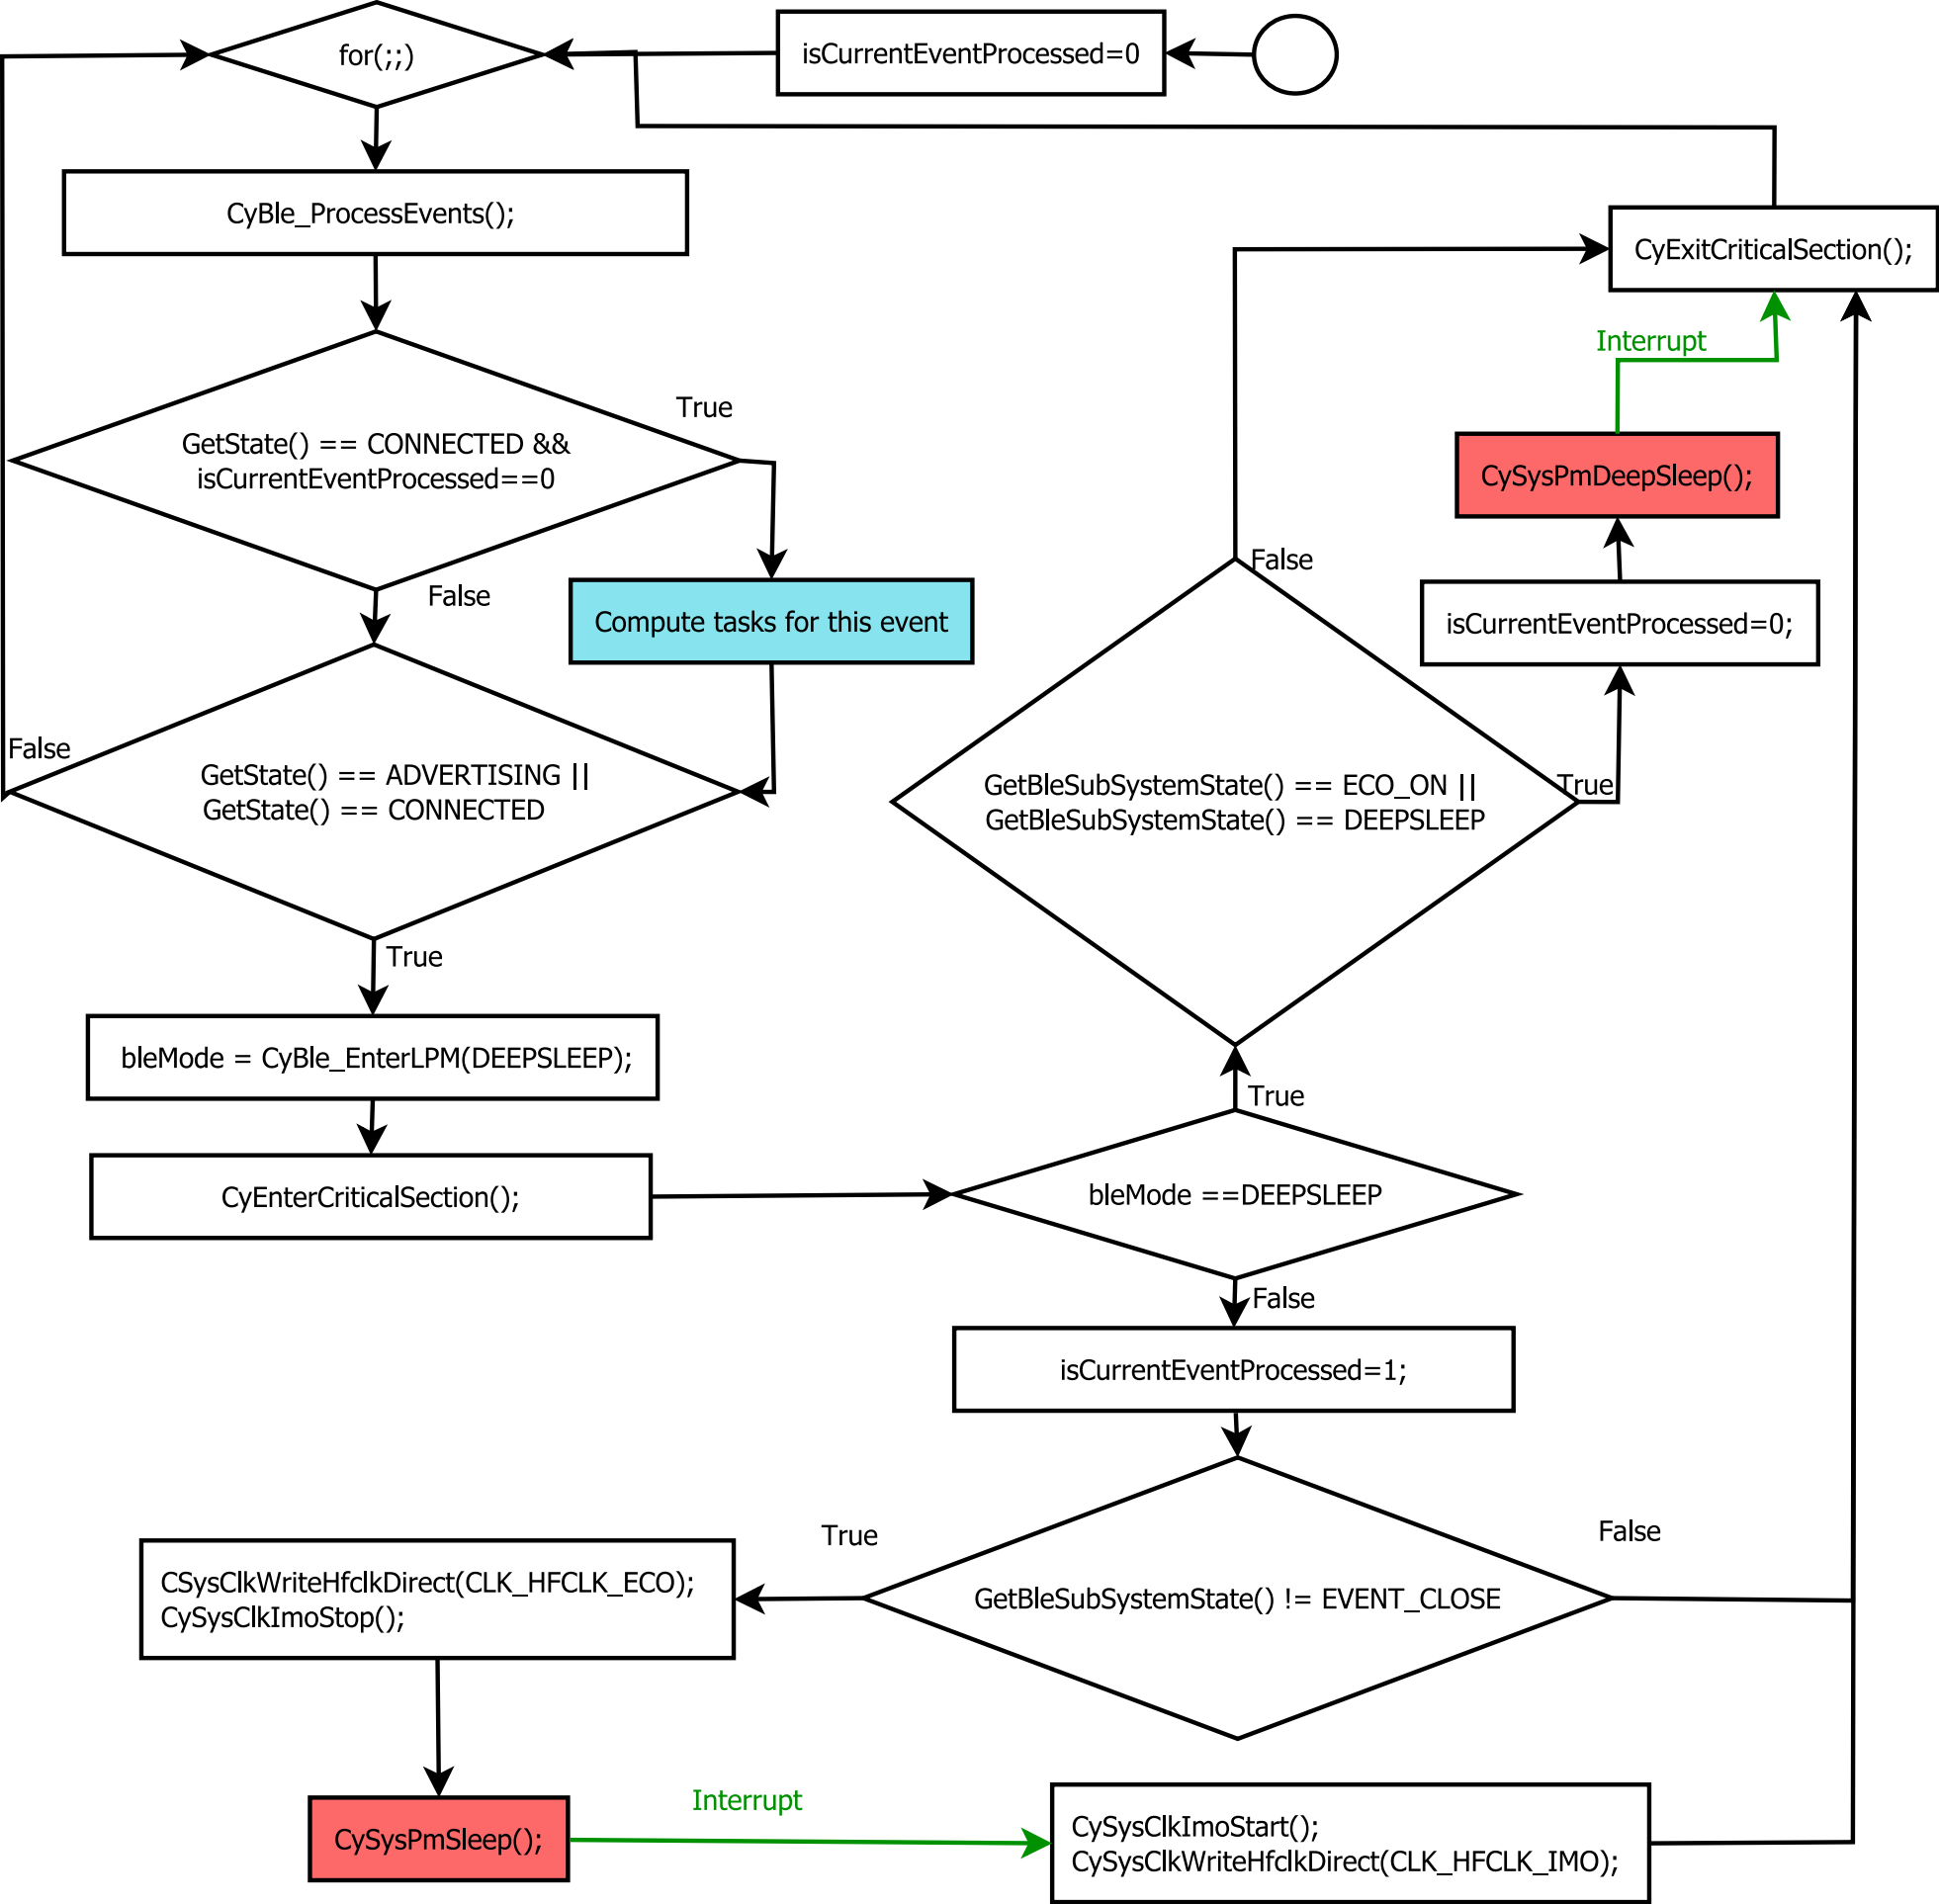
[picture p64: page 1]
