Xylons/TFG_Francisco_de_la_Mata/Proyecto_Android_low_powered_BLE_MAmIoT/Esquemas/filtro_complementario.pdf

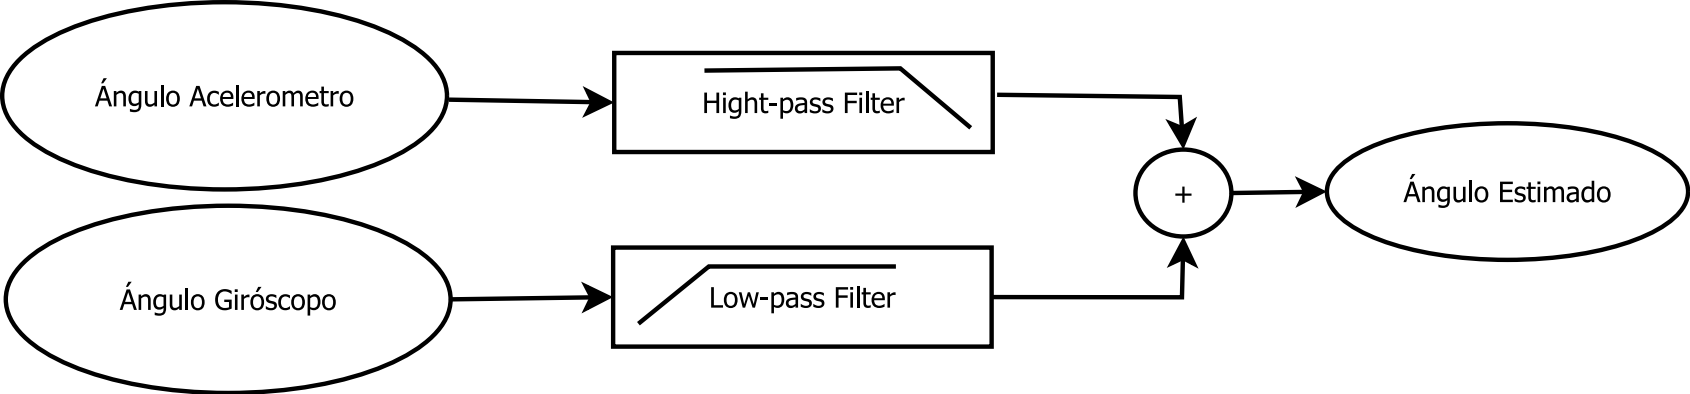
[picture p65: page 1]
