Xylons/TFG_Francisco_de_la_Mata/Proyecto_Android_low_powered_BLE_MAmIoT/Esquemas/prototipado_incremental.pdf

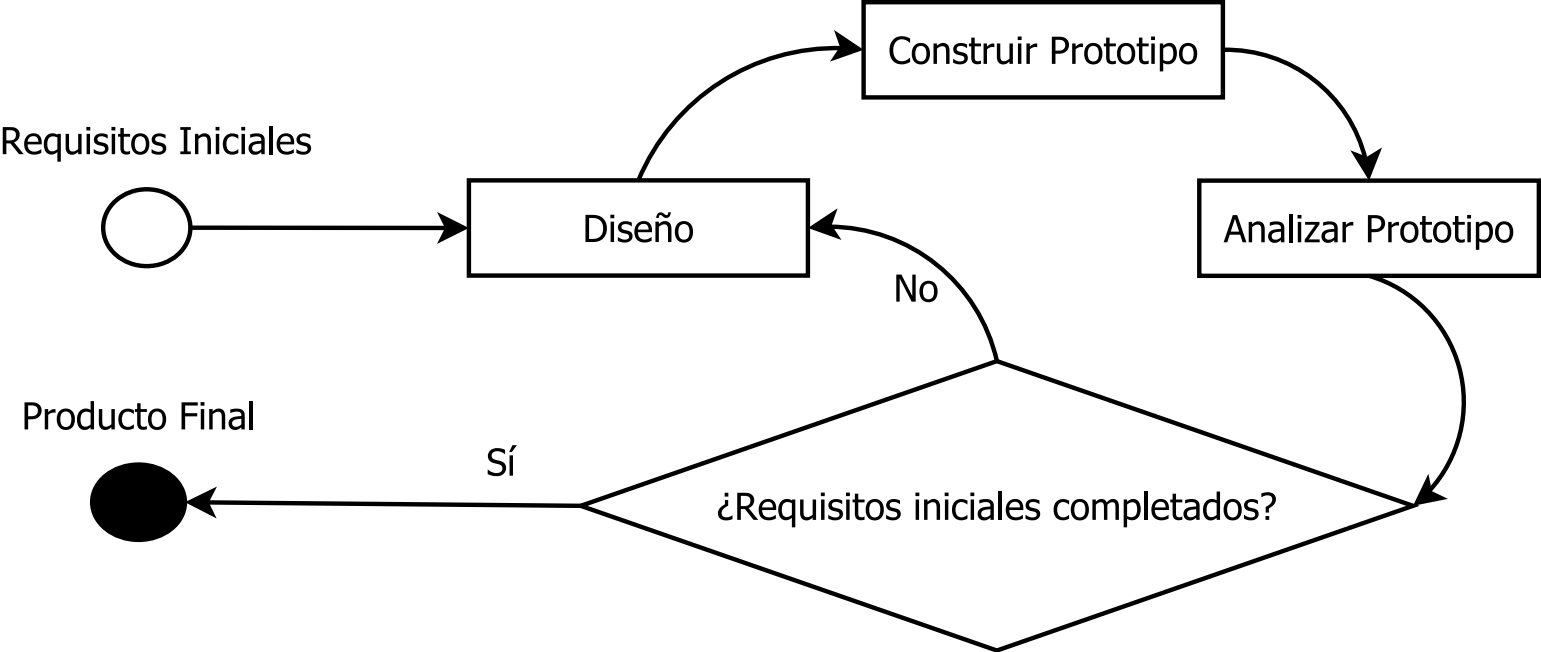
[picture p66: page 1]
