Xylons/TFG_Francisco_de_la_Mata/Proyecto_Android_low_powered_BLE_MAmIoT/KiCad/Insole_All_in_One_43_Left_old_usb/3m467_tape.pdf

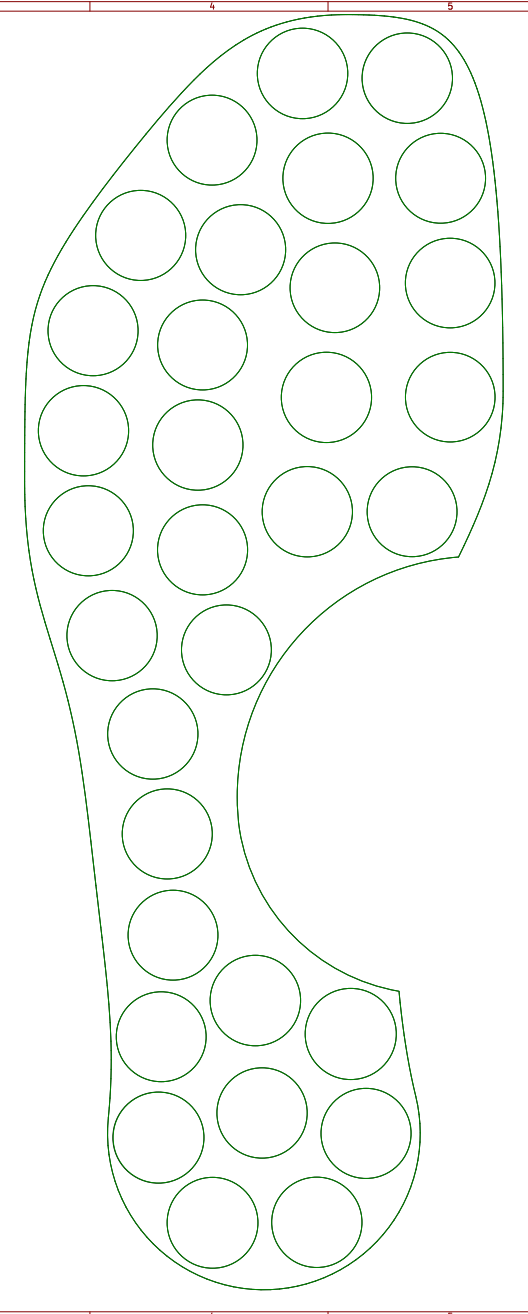
[picture p67: page 1]
