Xylons/TFG_Francisco_de_la_Mata/Proyecto_Android_low_powered_BLE_MAmIoT/KiCad/Prototypes_06_01_2020/OLD_29_01_2020_Left/Insole_All_in_One_43_LEFT/Insole_PCB.kicad_pcb

## KiCad design Proyecto_Android_low_powered_BLE_MAmIoT/KiCad/Prototypes_06_01_2020/OLD_29_01_2020_Left/Insole_All_in_One_43_LEFT/Insole_PCB.kicad_pcb (2020-07-15, an earlier design)

Schematic: Insole_PCB.sch, Insole Rigid Main Board

Parts:
C1, C5, C7, C9, C11, C13, C14, C16: 0.1uF; C_0603_1608Metric
C2, C6, C8, C10, C12, C15: 1uF; C_0603_1608Metric
C3: 4.7uF; C_0603_1608Metric
C4: 10uF; C_0603_1608Metric
C17: 100uF; CP_EIA-3528-12_Kemet-T
J1: Conn_Micro_USB; USB_Micro_CustomV2
J2: 3V7_Battery; PinHeader_1x02_P1.00mm_Vertical
L1, L2: 300ohm 100MHz; L_0805_2012Metric_Pad1.15x1.40mm_HandSolder
L3: 1uH; L_1206_3216Metric
MUX1, MUX2, MUX3, MUX4: CD74HC4051; TSSOP-16_4.4x5mm_P0.65mm
Q1, Q2: Q_PMOS_GSD; SOT-23
R1, R2, R3, R6, R7, R8, R9, R12, R13: 10k; R_0603_1608Metric
R4: 390 ohm; R_0603_1608Metric
R5: 0-1k; R_0603_1608Metric
R10: 2.7k; R_0603_1608Metric
R11: 100-500 ohm; R_0603_1608Metric
R14: 100k; R_0603_1608Metric
R15: 10k; R_0805_2012Metric
S0, S1, S2, S3, S4, S5, S6, S7, S8, S9, S10, S11, S12, S13, S14, S15, S16, S17, S18, S19, S20, S21, S22, S23, S24, S25, S26, S27, S28, S29, S30, S31: FSR; FSR_Circle_9mm
U1: STC4054-4.2; TSOT-23-5
U2: ISM330DLC; Bosch_LGA-14_3x2.5mm_P0.5mm
U3: ADP2108AUJ-3.3; TSOT-23-5
U4: CYBLE-222014-01
U5: AP9211SA-AN-HAC-7; AP9211SAACHAC7
U6, U7, U8, U9: TCMT1100; SOP-4_4.4x2.8mm_P1.27mm

Connections:
+3V3: C2.2, C4.1, C5.2, C6.2, C7.2, C8.2, C9.2, C10.2, C11.2, C12.2, C13.2, C17.1, L1.1, L2.1, L3.2, MUX1.3, MUX1.16, MUX2.3, MUX2.16, MUX3.3, MUX3.16, MUX4.3, MUX4.16, R2.1, R3.1, R11.2, U2.5, U2.8, U3.4 (FB), U6.4
+5V: C15.2, C16.2, J1.1, Q1.1, R15.2, U1.4, U6.2
+BATT: J2.2, Q1.2, R4.1, U1.3
-BATT: C1.2, C15.1, C16.1, J1.5, J1.6, J2.1, R1.2, U1.2, U5.1, U5.2
/+3V3_VDD: L2.2, U4.14
/+3V3_VDDR: L1.2, U4.5
/+BATT_CUT: C3.2, Q1.3, Q2.2, R14.1, U3.1 (Vin), U3.3 (EN)
/MUX_E: MUX1.6, MUX2.6, MUX3.6, MUX4.6, U4.7
/P0.6_USB: J1.3, U8.4
/P0.7_USB: J1.4, U9.4
/S0: MUX1.11, MUX2.11, MUX3.11, MUX4.11, U4.19
/S1: MUX1.10, MUX2.10, MUX3.10, MUX4.10, U4.20
/S2: MUX1.9, MUX2.9, MUX3.9, MUX4.9, U4.21
/U1_A0: MUX1.13, S0.2
/U1_A1: MUX1.14, S1.2
/U1_A2: MUX1.15, S2.2
/U1_A3: MUX1.12, S3.2
/U1_A4: MUX1.1, S4.2
/U1_A5: MUX1.5, S5.2
/U1_A6: MUX1.2, S6.2
/U1_A7: MUX1.4, S7.2
/U1_Data: R9.2, S0.1, S1.1, S2.1, S3.1, S4.1, S5.1, S6.1, S7.1, U4.18
/U2_A0: MUX2.13, S8.2
/U2_A1: MUX2.14, S9.2
/U2_A2: MUX2.15, S10.2
/U2_A3: MUX2.12, S11.2
/U2_A4: MUX2.1, S12.2
/U2_A5: MUX2.5, S13.2
/U2_A6: MUX2.2, S14.2
/U2_A7: MUX2.4, S15.2
/U2_Data: R8.2, S8.1, S9.1, S10.1, S11.1, S12.1, S13.1, S14.1, S15.1, U4.17
/U3_A0: MUX3.13, S16.2
/U3_A1: MUX3.14, S17.2
/U3_A2: MUX3.15, S18.2
/U3_A3: MUX3.12, S19.2
/U3_A4: MUX3.1, S20.2
/U3_A5: MUX3.5, S21.2
/U3_A6: MUX3.2, S22.2
/U3_A7: MUX3.4, S23.2
/U3_Data: R7.2, S16.1, S17.1, S18.1, S19.1, S20.1, S21.1, S22.1, S23.1, U4.16
/U4_A0: MUX4.13, S24.2
/U4_A1: MUX4.14, S25.2
/U4_A2: MUX4.15, S26.2
/U4_A3: MUX4.12, S27.2
/U4_A4: MUX4.1, S28.2
/U4_A5: MUX4.5, S29.2
/U4_A6: MUX4.2, S30.2
/U4_A7: MUX4.4, S31.2
/U4_Data: R6.2, S24.1, S25.1, S26.1, S27.1, S28.1, S29.1, S30.1, S31.1, U4.13
/XRES_USB: J1.2, U7.4
Analog_Batt_Lvl: C14.1, R12.2, R13.1, U4.4
Enable_Batt_Lvl: Q2.1, R14.2, U4.3
GND: C2.1, C3.1, C4.2, C5.1, C6.1, C7.1, C8.1, C9.1, C10.1, C11.1, C12.1, C13.1, C14.2, C17.2, MUX1.7, MUX1.8, MUX2.7, MUX2.8, MUX3.7, MUX3.8, MUX4.7, MUX4.8, R6.1, R7.1, R8.1, R9.1, R10.2, R13.2, R15.1, U2.1, U2.2, U2.3, U2.6, U2.7, U3.2 (GND), U4.1, U4.11, U5.6, U7.2, U8.2, U9.2
unnamed: C1.1, R4.2, U5.3
unnamed: L3.1, U3.5 (SW)
unnamed: Q2.3, R12.1
unnamed: R1.1, U1.5
unnamed: R2.2, U2.14, U4.9
unnamed: R3.2, U2.13, U4.10
unnamed: R5.1, U7.1, U8.1, U9.1
unnamed: R5.2, U6.3
unnamed: R10.1, U5.5
unnamed: R11.1, U6.1
P0.6: U4.12, U8.3
P0.7: U4.8, U9.3
XRES: U4.15, U7.3

Notes on the sheet:
Measure Battery level
Battery Protection
Close to pin 16 from MUX1
Close to pin 5 from U2
Close to pin 16 from MUX2
Close to pin 16 from MUX3
Close to pin 16 from MUX4
Close to pin 4 from U1

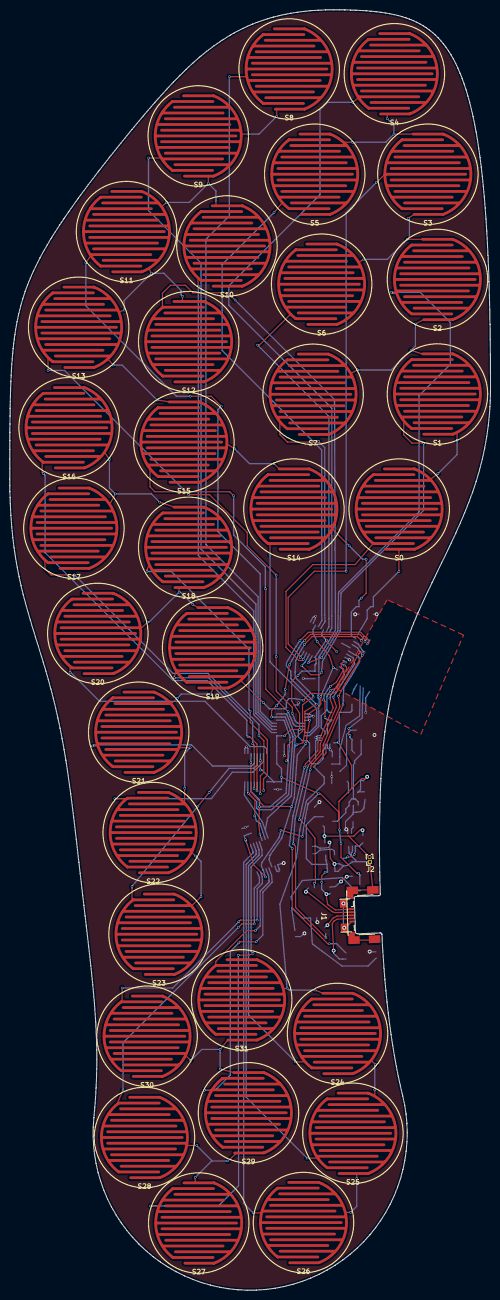
[picture p68: board Proyecto_Android_low_powered_BLE_MAmIoT/KiCad/Prototypes_06_01_2020/O… from above]

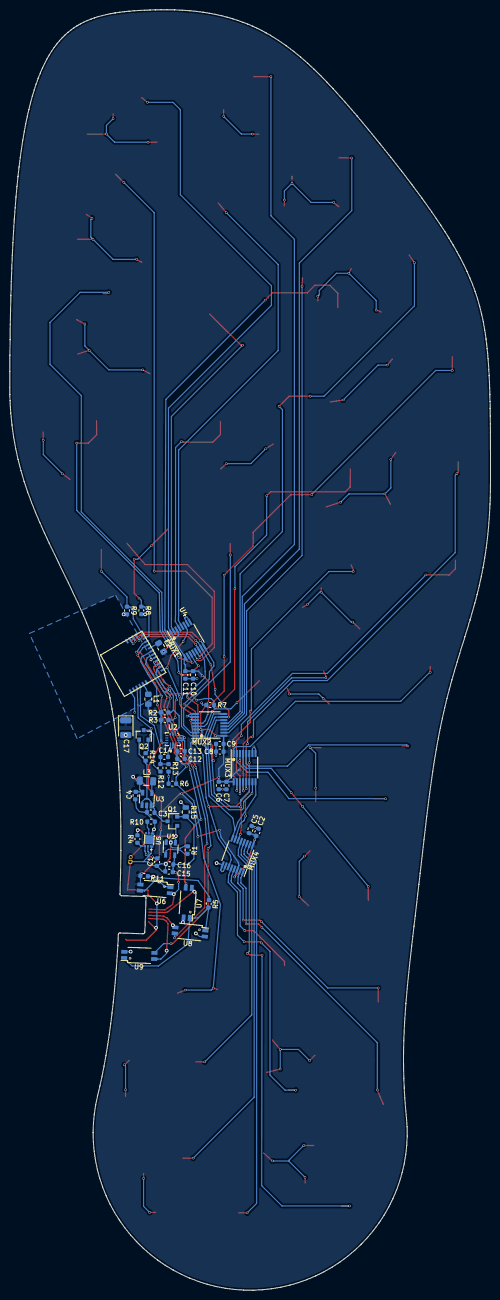
[picture p69: board Proyecto_Android_low_powered_BLE_MAmIoT/KiCad/Prototypes_06_01_2020/O… from below]

Board: 2 copper layers, 100.5 x 267.7 mm, 84 parts (50 on the bottom side), 66 nets.
