Xylons/TFG_Francisco_de_la_Mata/Proyecto_Android_low_powered_BLE_MAmIoT/KiCad/Insole_PCB_production_32_sensors/Insole_PCB.kicad_pcb

## KiCad design Proyecto_Android_low_powered_BLE_MAmIoT/KiCad/Insole_PCB_production_32_sensors/Insole_PCB.kicad_pcb (2020-07-15)

Schematic: Insole_PCB.sch, Insole Rigid Main Board

Parts:
C1, C2: 1uF; C_0603_1608Metric_Pad1.05x0.95mm_HandSolder
C3: 4.7uF; C_0603_1608Metric_Pad1.05x0.95mm_HandSolder
C4: 10uF; C_0603_1608Metric_Pad1.05x0.95mm_HandSolder
J1: 5V_Qi; PinHeader_1x02_P1.00mm_Vertical
J2: 3V7_Battery; PinHeader_1x02_P1.00mm_Vertical
J3: SWD; PinHeader_1x04_P1.00mm_Vertical
J4: Conn_01x36_Male; Hirose_FH12-36S-0.5SH_1x36-1MP_P0.50mm_Horizontal
L1, L2: 300ohm 100MHz; L_0805_2012Metric_Pad1.15x1.40mm_HandSolder
L3: 1uH; L_0805_2012Metric_Pad1.15x1.40mm_HandSolder
R1, R2, R3, R4, R5, R6, R7: 10k; R_0603_1608Metric_Pad1.05x0.95mm_HandSolder
R9: 1M; R_0603_1608Metric_Pad1.05x0.95mm_HandSolder
R10: 200k; R_0603_1608Metric_Pad1.05x0.95mm_HandSolder
U1, U2, U3, U4: CD74HC4051; TSSOP-16_4.4x5mm_P0.65mm
U5: CYBLE-222014-01
U6: STC4054-4.2; TSOT-23-5
U7: ISM330DLC; Bosch_LGA-14_3x2.5mm_P0.5mm
U8: ADP2108AUJ-3.3; TSOT-23-5

Connections:
+3V3: C1.1, C4.1, L1.1, L2.1, L3.2, R2.1, R3.1, U1.3, U1.16, U2.3, U2.16, U3.3, U3.16, U4.3, U4.16, U7.5, U7.8, U8.4 (FB)
+5V: C2.2, J1.2, U6.4
+BATT: C3.2, J2.2, R9.2, U6.3, U8.1 (Vin), U8.3 (EN)
/MUX_E: U1.6, U2.6, U3.6, U4.6, U5.7
/S0: U1.11, U2.11, U3.11, U4.11, U5.19
/S1: U1.10, U2.10, U3.10, U4.10, U5.20
/S2: U1.9, U2.9, U3.9, U4.9, U5.21
/U1_A0: J4.8, U1.13
/U1_A1: J4.7, U1.14
/U1_A2: J4.6, U1.15
/U1_A3: J4.5, U1.12
/U1_A4: J4.4, U1.1
/U1_A5: J4.3, U1.5
/U1_A6: J4.2, U1.2
/U1_A7: J4.1, U1.4
/U1_Data: J4.17, R7.2, U5.18
/U2_A0: J4.16, U2.13
/U2_A1: J4.15, U2.14
/U2_A2: J4.14, U2.15
/U2_A3: J4.13, U2.12
/U2_A4: J4.12, U2.1
/U2_A5: J4.11, U2.5
/U2_A6: J4.10, U2.2
/U2_A7: J4.9, U2.4
/U2_Data: J4.18, R6.2, U5.17
/U3_A0: J4.28, U3.13
/U3_A1: J4.27, U3.14
/U3_A2: J4.26, U3.15
/U3_A3: J4.25, U3.12
/U3_A4: J4.24, U3.1
/U3_A5: J4.23, U3.5
/U3_A6: J4.22, U3.2
/U3_A7: J4.21, U3.4
/U3_Data: J4.19, R5.2, U5.16
/U4_A0: J4.36, U4.13
/U4_A1: J4.35, U4.14
/U4_A2: J4.34, U4.15
/U4_A3: J4.33, U4.12
/U4_A4: J4.32, U4.1
/U4_A5: J4.31, U4.5
/U4_A6: J4.30, U4.2
/U4_A7: J4.29, U4.4
/U4_Data: J4.20, R4.2, U5.13
GND: C1.2, C2.1, C3.1, C4.2, J1.1, J2.1, J3.1, R1.2, R4.1, R5.1, R6.1, R7.1, R10.1, U1.7, U1.8, U2.7, U2.8, U3.7, U3.8, U4.7, U4.8, U5.1, U5.11, U6.2, U7.1, U7.2, U7.3, U7.6, U7.7, U8.2 (GND)
unnamed: J3.2, U5.15
unnamed: J3.3, U5.8
unnamed: J3.4, U5.12
unnamed: L1.2, U5.5
unnamed: L2.2, U5.14
unnamed: L3.1, U8.5 (SW)
unnamed: R1.1, U6.5
unnamed: R2.2, U5.9, U7.14
unnamed: R3.2, U5.10, U7.13
unnamed: R9.1, R10.2, U5.22

Notes on the sheet:
Measure Battery level

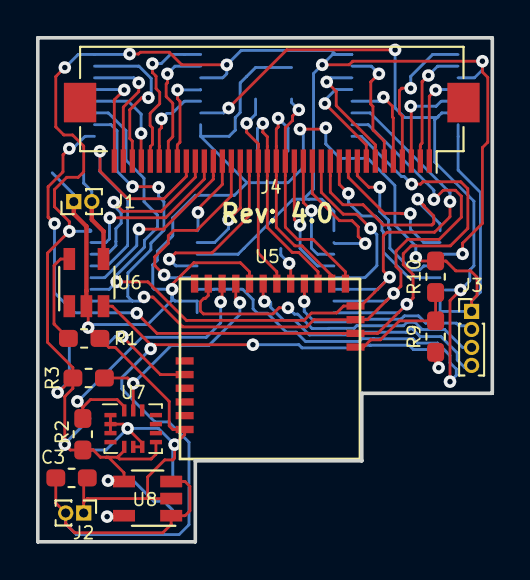
[picture p70: board Proyecto_Android_low_powered_BLE_MAmIoT/KiCad/Insole_PCB_production_3… from above]

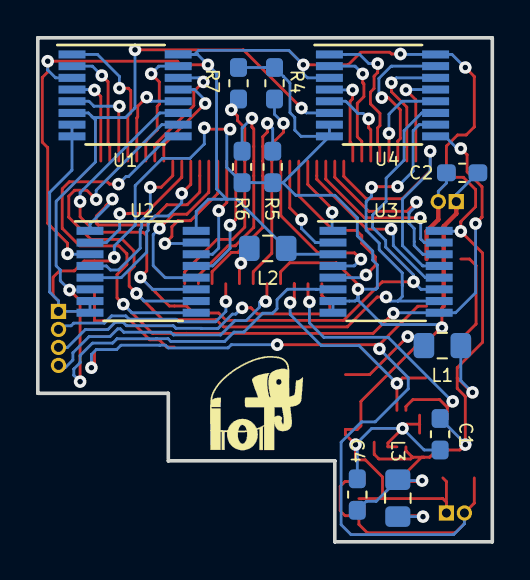
[picture p71: board Proyecto_Android_low_powered_BLE_MAmIoT/KiCad/Insole_PCB_production_3… from below]

Board: 2 copper layers, 25.2 x 28.0 mm, 28 parts (14 on the bottom side), 54 nets.
