Xylons/TFG_Francisco_de_la_Mata/Proyecto_Android_low_powered_BLE_MAmIoT/KiCad/Previous_versions/Insole_right/insole_right.kicad_pcb

## KiCad design Proyecto_Android_low_powered_BLE_MAmIoT/KiCad/Previous_versions/Insole_right/insole_right.kicad_pcb (2020-07-15, an earlier design)

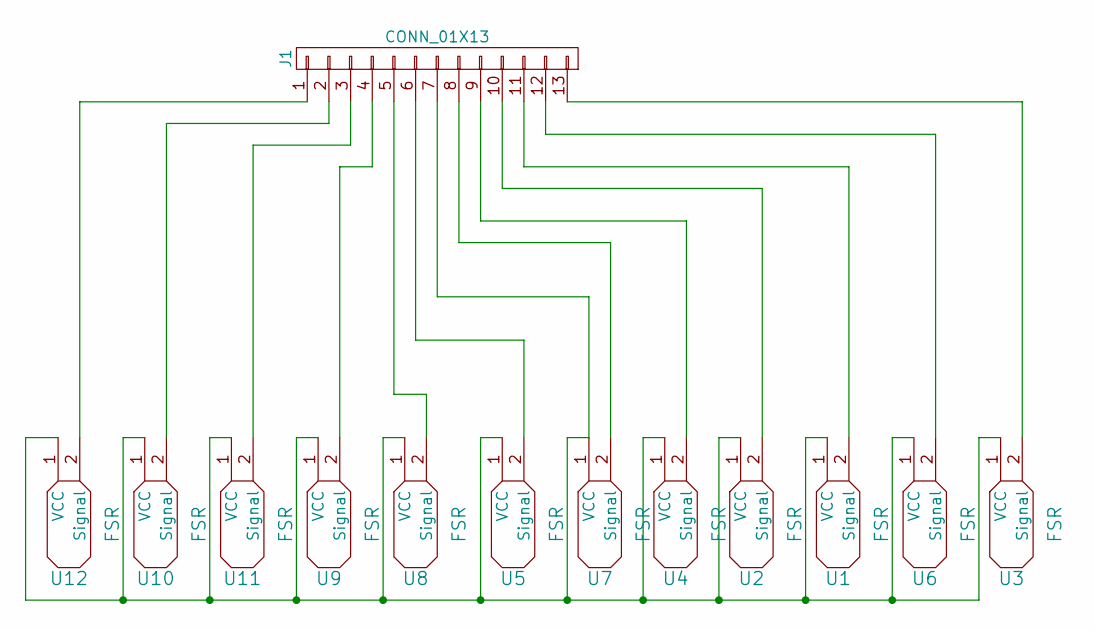
[picture p72: schematic insole_right.sch]

Parts:
J1: CONN_01X13; Conn_FPC_1mm
U1, U2, U3, U4, U5, U6, U7, U8, U9, U10, U11, U12: FSR; FSR15x30mm

Connections:
unnamed: J1.1, U12.2 (Signal)
unnamed: J1.2, U10.2 (Signal)
unnamed: J1.3, U11.2 (Signal)
unnamed: J1.4, U9.2 (Signal)
unnamed: J1.5, U8.2 (Signal)
unnamed: J1.6, U5.2 (Signal)
unnamed: J1.7, U1.1 (VCC), U2.1 (VCC), U3.1 (VCC), U4.1 (VCC), U5.1 (VCC), U6.1 (VCC), U7.1 (VCC), U8.1 (VCC), U9.1 (VCC), U10.1 (VCC), U11.1 (VCC), U12.1 (VCC)
unnamed: J1.8, U7.2 (Signal)
unnamed: J1.9, U4.2 (Signal)
unnamed: J1.10, U2.2 (Signal)
unnamed: J1.11, U1.2 (Signal)
unnamed: J1.12, U6.2 (Signal)
unnamed: J1.13, U3.2 (Signal)

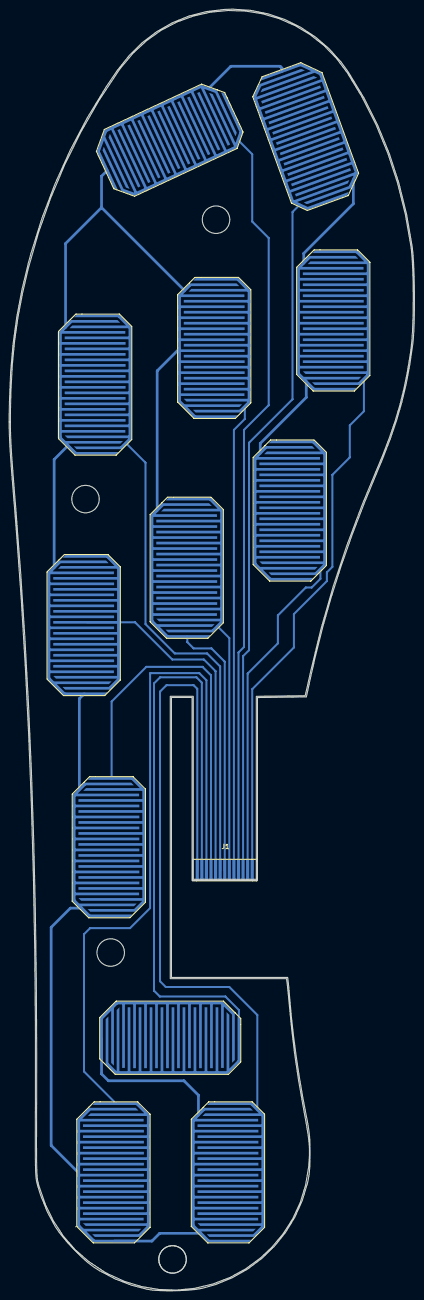
[picture p73: board insole_right.kicad_pcb from below]

Board: 2 copper layers, 88.5 x 279.8 mm, 13 parts (13 on the bottom side), 13 nets.
