Xylons/TFG_Francisco_de_la_Mata/Proyecto_Android_low_powered_BLE_MAmIoT/KiCad/Insole_flex_left_32_sensors_right/Insole_flex_32s.kicad_pcb

## KiCad design Proyecto_Android_low_powered_BLE_MAmIoT/KiCad/Insole_flex_left_32_sensors_right/Insole_flex_32s.kicad_pcb (2020-07-15)

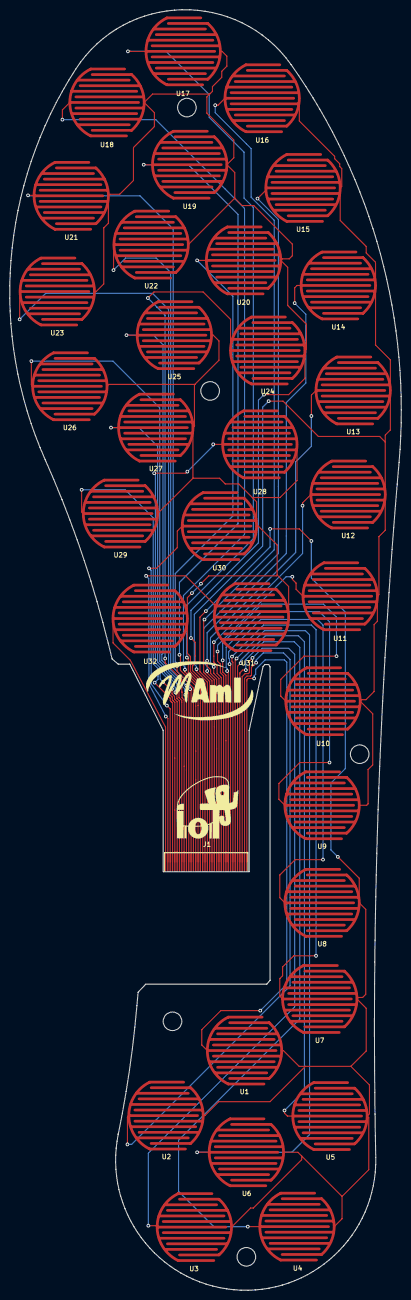
[picture p74: board Insole_flex_32s.kicad_pcb from above]

Board: 2 copper layers, 84.3 x 275.6 mm, 33 parts (0 on the bottom side), 36 nets.

Parts:
J1: Conn_01x36_Male; fpc_female_36_pitch_0.5mm
U1, U2, U3, U4, U5, U6, U7, U8, U9, U10, U11, U12, U13, U14, U15, U16, U17, U18, U19, U20, U21, U22, U23, U24, U25, U26, U27, U28, U29, U30, U31, U32: FSR; FSR_Circle_8mm

Connections:
unnamed: J1.1, U1.2
unnamed: J1.2, U2.2
unnamed: J1.3, U3.2
unnamed: J1.4, U4.2
unnamed: J1.5, U5.2
unnamed: J1.6, U6.2
unnamed: J1.7, U7.2
unnamed: J1.8, U8.2
unnamed: J1.9, U9.2
unnamed: J1.10, U10.2
unnamed: J1.11, U11.2
unnamed: J1.12, U12.2
unnamed: J1.13, U13.2
unnamed: J1.14, U14.2
unnamed: J1.15, U15.2
unnamed: J1.16, U16.2
unnamed: J1.17, U1.1, U2.1, U3.1, U4.1, U5.1, U6.1, U7.1, U8.1
unnamed: J1.18, U9.1, U10.1, U11.1, U12.1, U13.1, U14.1, U15.1, U16.1
unnamed: J1.19, U17.1, U18.1, U19.1, U20.1, U21.1, U22.1, U23.1, U24.1
unnamed: J1.20, U25.1, U26.1, U27.1, U28.1, U29.1, U30.1, U31.1, U32.1
unnamed: J1.21, U17.2
unnamed: J1.22, U18.2
unnamed: J1.23, U19.2
unnamed: J1.24, U20.2
unnamed: J1.25, U21.2
unnamed: J1.26, U22.2
unnamed: J1.27, U23.2
unnamed: J1.28, U24.2
unnamed: J1.29, U25.2
unnamed: J1.30, U26.2
unnamed: J1.31, U27.2
unnamed: J1.32, U28.2
unnamed: J1.33, U29.2
unnamed: J1.34, U30.2
unnamed: J1.35, U31.2
unnamed: J1.36, U32.2
