Xylons/TFG_Francisco_de_la_Mata/Proyecto_Android_low_powered_BLE_MAmIoT/KiCad/Previous_versions/Main_Board/Insoles_Board.kicad_pcb

## KiCad design Proyecto_Android_low_powered_BLE_MAmIoT/KiCad/Previous_versions/Main_Board/Insoles_Board.kicad_pcb (2020-07-15, an earlier design)

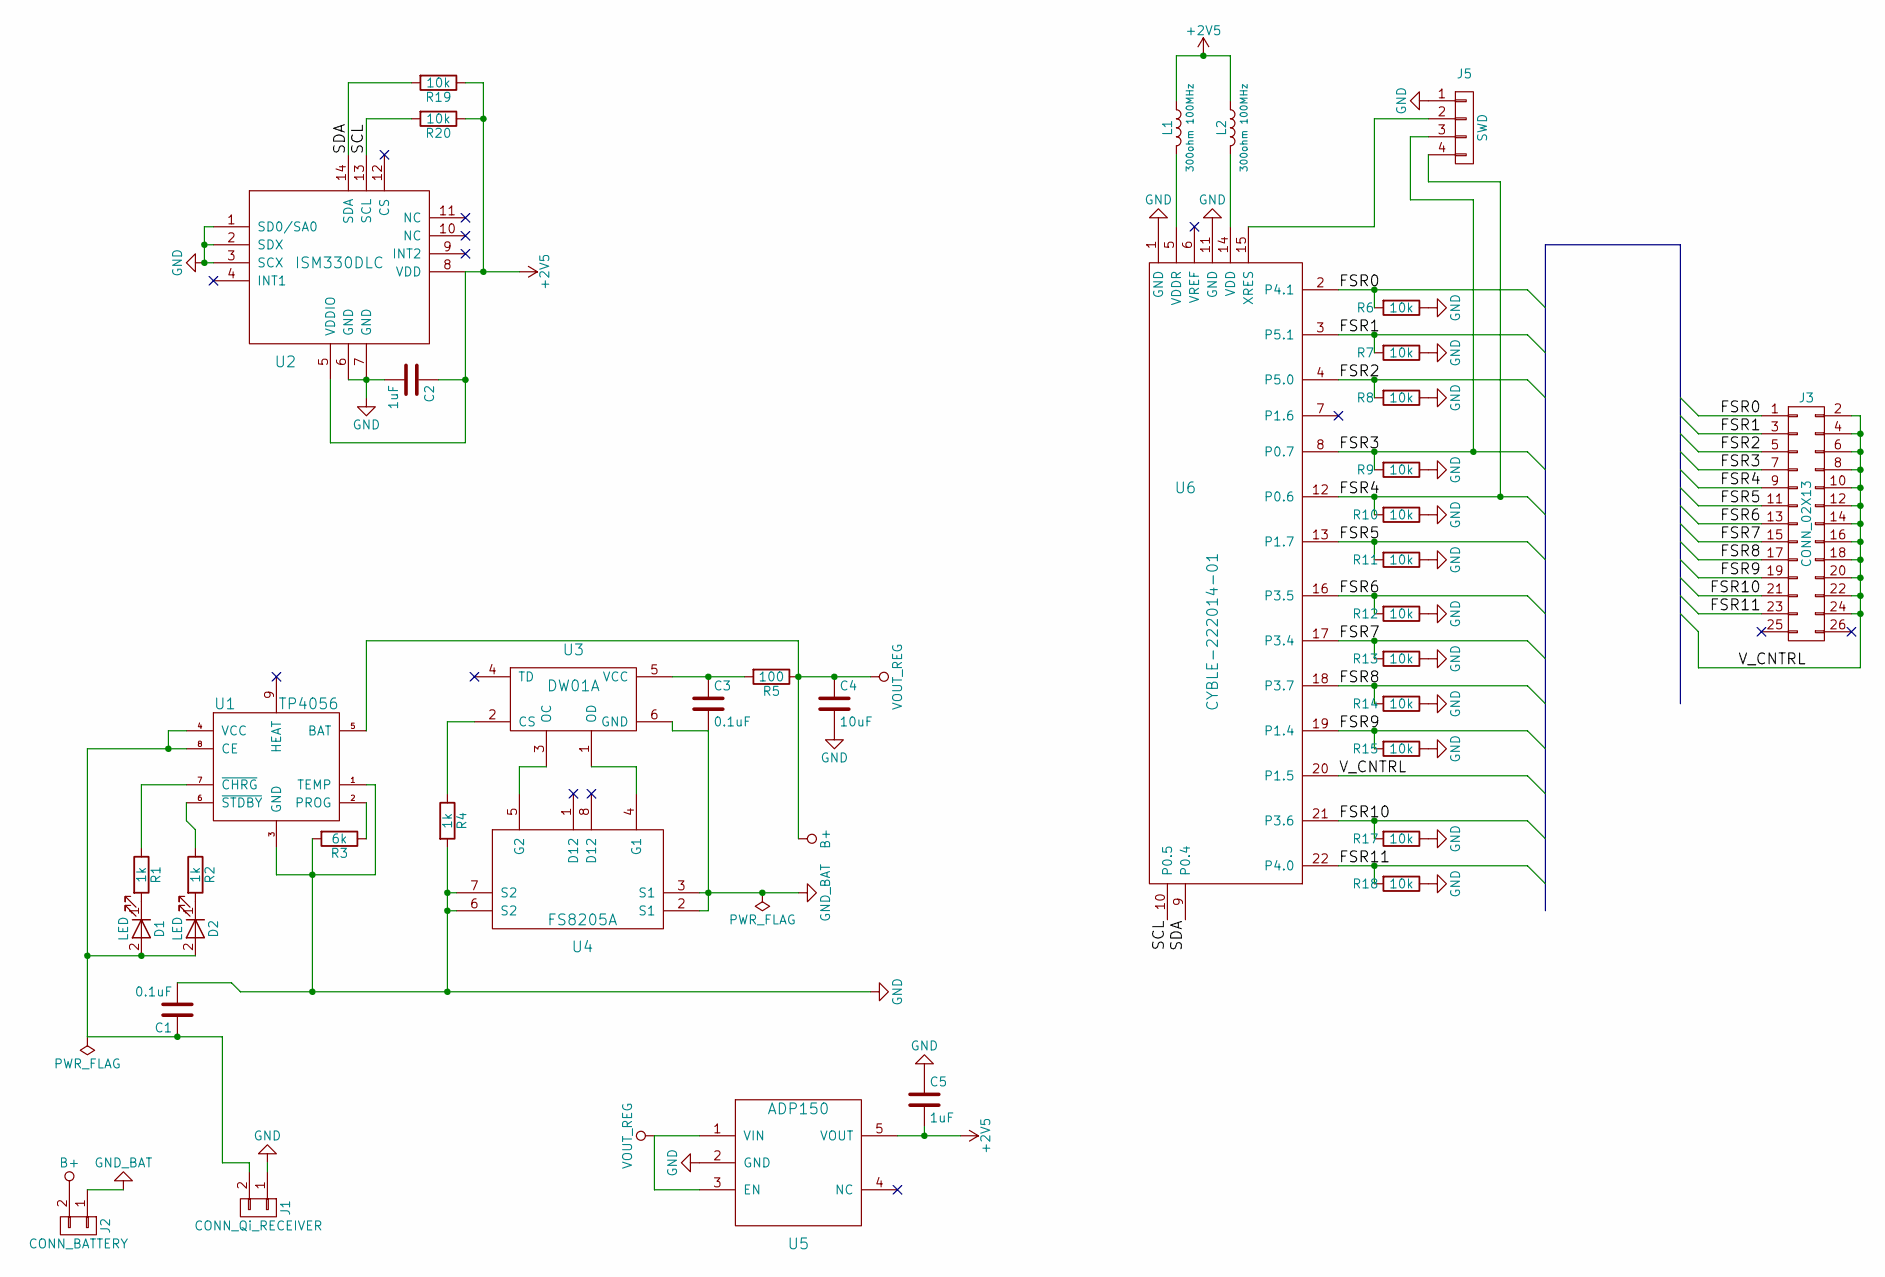
[picture p75: schematic Insoles_Board.sch, SOC_Board]

Parts:
C1, C3: 0.1uF; C_0603
C2, C5: 1uF; C_0603
C4: 10uF; C_0603
D1, D2: LED; LED_1206
J1: CONN_Qi_RECEIVER; GS2
J2: CONN_BATTERY; GS2
J3: CONN_02X13; Socket_Strip_Straight_2x13_Pitch1.27mm_SMD
J5: SWD; Hirose_DF13-04P-1.25DS_04x1.25mm_Angled
L1, L2: 300ohm 100MHz; L_0805
R1, R2, R4: 1k; R_0603
R3: 6k; R_0603
R5: 100; R_0603
R6, R7, R8, R9, R10, R11, R12, R13, R14, R15, R17, R18, R19, R20: 10k; R_0603
U1: TP4056; Diodes_PSOP-8
U2: ISM330DLC; Bosch_LGA-14_3x2.5mm_Pitch0.5mm
U3: DW01A; SOT-23-6_Handsoldering
U4: FS8205A; TSSOP-8_4.4x3mm_Pitch0.65mm
U5: ADP150; SOT-23-5_HandSoldering
U6: CYBLE-222014-01; CYBLE-222014-00

Connections:
+2V5: C2.1, C5.2, L1.1, L2.1, R19.1, R20.1, U2.5 (VDDIO), U2.8 (VDD), U5.5 (VOUT)
/FSR0: J3.1, R6.2, U6.2 (P4.1)
/FSR1: J3.3, R7.2, U6.3 (P5.1)
/FSR2: J3.5, R8.2, U6.4 (P5.0)
/FSR3: J3.7, J5.3, R9.2, U6.8 (P0.7)
/FSR4: J3.9, J5.4, R10.2, U6.12 (P0.6)
/FSR5: J3.11, R11.2, U6.13 (P1.7)
/FSR6: J3.13, R12.2, U6.16 (P3.5)
/FSR7: J3.15, R13.2, U6.17 (P3.4)
/FSR8: J3.17, R14.2, U6.18 (P3.7)
/FSR9: J3.19, R15.2, U6.19 (P1.4)
/FSR10: J3.21, R17.2, U6.21 (P3.6)
/FSR11: J3.23, R18.2, U6.22 (P4.0)
/SCL: R20.2, U2.13 (SCL), U6.10 (P0.5)
/SDA: R19.2, U2.14 (SDA), U6.9 (P0.4)
/V_CNTRL: J3.2, J3.4, J3.6, J3.8, J3.10, J3.12, J3.14, J3.16, J3.18, J3.20, J3.22, J3.24, U6.20 (P1.5)
B+: C4.1, J2.2, R5.1, U1.5 (BAT), U5.1 (VIN), U5.3 (EN)
GND: C1.2, C2.2, C4.2, C5.1, J1.1, J5.1, R3.2, R4.2, R6.1, R7.1, R8.1, R9.1, R10.1, R11.1, R12.1, R13.1, R14.1, R15.1, R17.1, R18.1, U1.1 (TEMP), U1.3 (GND), U2.1 (SD0/SA0), U2.2 (SDX), U2.3 (SCX), U2.6 (GND), U2.7 (GND), U4.6 (S2), U4.7 (S2), U5.2 (GND), U6.1 (GND), U6.11 (GND)
GND_BAT: C3.2, J2.1, U3.6 (GND), U4.2 (S1), U4.3 (S1)
unnamed: C1.1, D1.2 (A), D2.2 (A), J1.2, U1.4 (VCC), U1.8 (CE)
unnamed: C3.1, R5.2, U3.5 (VCC)
unnamed: D1.1 (K), R1.2
unnamed: D2.1 (K), R2.2
unnamed: J5.2, U6.15 (XRES)
unnamed: L1.2, U6.5 (VDDR)
unnamed: L2.2, U6.14 (VDD)
unnamed: R1.1, U1.7 (~CHRG)
unnamed: R2.1, U1.6 (~STDBY)
unnamed: R3.1, U1.2 (PROG)
unnamed: R4.1, U3.2 (CS)
unnamed: U3.1 (OD), U4.4 (G1)
unnamed: U3.3 (OC), U4.5 (G2)

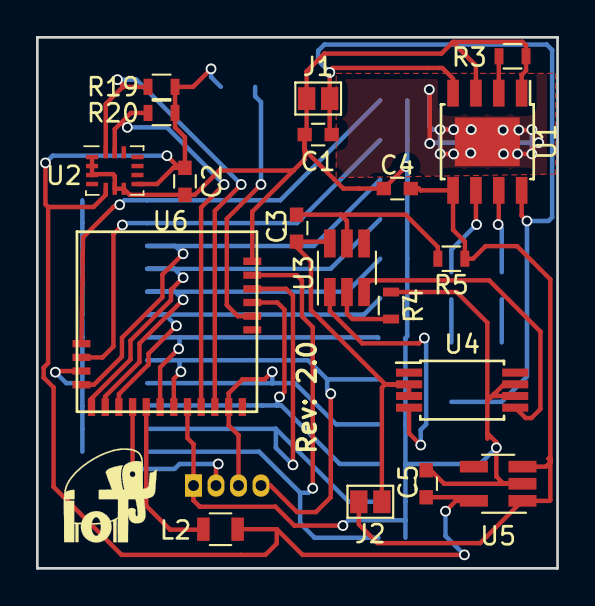
[picture p76: board Insoles_Board.kicad_pcb from above]

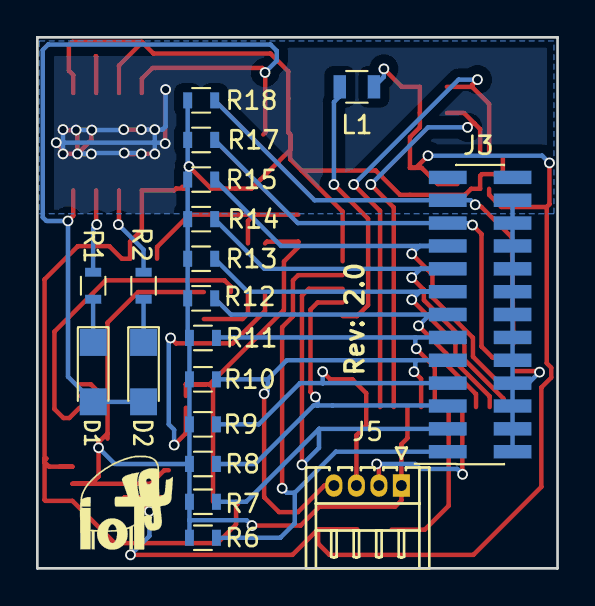
[picture p77: board Insoles_Board.kicad_pcb from below]

Board: 2 copper layers, 28.9 x 29.5 mm, 38 parts (19 on the bottom side), 32 nets.
