Xylons/TFG_Francisco_de_la_Mata/Proyecto_Android_low_powered_BLE_MAmIoT/Firmware_TFG_Left/BLE_Battery_Level01.cydsn/main.c

/*******************************************************************************
* File Name: main.c
*
* Version: 1.0
*
* Description:
*  BLE example project that measures the battery voltage using PSoC 4 BLE's 
*  internal ADC and notifies the BLE central device on any change in battery 
*  voltage.
*
* Note:
*
* Hardware Dependency:
*  CY8CKIT-042 BLE
* 
********************************************************************************
* Copyright 2016, Cypress Semiconductor Corporation.  All rights reserved.
* You may use this file only in accordance with the license, terms, conditions,
* disclaimers, and limitations in the end user license agreement accompanying
* the software package with which this file was provided.
*******************************************************************************/

#include "common.h"
#include "bas.h"


/*******************************************************************************
* Function Name: AppCallBack()
********************************************************************************
*
* Summary:
*   This is an event callback function to receive events from the BLE Component.
*
*  event - the event code
*  *eventParam - the event parameters
*
* Return:
*   None
*
*******************************************************************************/
void AppCallBack(uint32 event, void* eventParam)
{
    CYBLE_API_RESULT_T apiResult;
    CYBLE_GAP_BD_ADDR_T localAddr;
    uint8 i;

    switch (event)
	{
        /**********************************************************
        *                       General Events
        ***********************************************************/
		case CYBLE_EVT_STACK_ON: /* This event is received when the component is Started */
            /* Enter into discoverable mode so that remote can search it. */
            apiResult = CyBle_GappStartAdvertisement(CYBLE_ADVERTISING_FAST);
            if(apiResult != CYBLE_ERROR_OK)
            {
                DBG_PRINTF("StartAdvertisement API Error: %d \r\n", apiResult);
                ShowError();
            }
            DBG_PRINTF("Bluetooth On, StartAdvertisement with addr: ");
            localAddr.type = 0u;
            CyBle_GetDeviceAddress(&localAddr);
            for(i = CYBLE_GAP_BD_ADDR_SIZE; i > 0u; i--)
            {
                DBG_PRINTF("%2.2x", localAddr.bdAddr[i-1]);
            }
            DBG_PRINTF("\r\n");
            break;
		case CYBLE_EVT_TIMEOUT: 
			break;
		case CYBLE_EVT_HARDWARE_ERROR:    /* This event indicates that some internal HW error has occurred. */
            DBG_PRINTF("Hardware Error \r\n");
            ShowError();
			break;
        case CYBLE_EVT_HCI_STATUS:
            DBG_PRINTF("CYBLE_EVT_HCI_STATUS: %x \r\n", *(uint8 *)eventParam);
            ShowError();
			break;
            
        /**********************************************************
        *                       GAP Events
        ***********************************************************/
        case CYBLE_EVT_GAPP_ADVERTISEMENT_START_STOP:
            DBG_PRINTF("CYBLE_EVT_GAPP_ADVERTISEMENT_START_STOP, state: %x\r\n", CyBle_GetState());
            if(CYBLE_STATE_DISCONNECTED == CyBle_GetState())
            {   
                /* Fast and slow advertising period complete, go to low power  
                 * mode (Hibernate mode) and wait for an external
                 * user event to wake up the device again */
                DBG_PRINTF("Hibernate \r\n");
                Advertising_LED_Write(LED_OFF);
                Disconnect_LED_Write(LED_ON);
                LowPower_LED_Write(LED_OFF);
            #if (DEBUG_UART_ENABLED == ENABLED)
                while((UART_DEB_SpiUartGetTxBufferSize() + UART_DEB_GET_TX_FIFO_SR_VALID) != 0);
            #endif /* (DEBUG_UART_ENABLED == ENABLED) */
                SW2_ClearInterrupt();
                Wakeup_Interrupt_ClearPending();
                Wakeup_Interrupt_Start();
                CySysPmHibernate();
            }
            break;
        case CYBLE_EVT_GAP_DEVICE_CONNECTED:
            DBG_PRINTF("CYBLE_EVT_GAP_DEVICE_CONNECTED: %d \r\n", *(uint8 *)eventParam);
            Advertising_LED_Write(LED_OFF);
            break;
        case CYBLE_EVT_GAP_DEVICE_DISCONNECTED:
            DBG_PRINTF("CYBLE_EVT_GAP_DEVICE_DISCONNECTED\r\n");
            LowPower_LED_Write(LED_OFF);
            /* Put the device into discoverable mode so that a remote can search it. */
            apiResult = CyBle_GappStartAdvertisement(CYBLE_ADVERTISING_FAST);
            if(apiResult != CYBLE_ERROR_OK)
            {
                DBG_PRINTF("StartAdvertisement API Error: %d \r\n", apiResult);
                ShowError();
            }
            break;
            
        /**********************************************************
        *                       GATT Events
        ***********************************************************/
        case CYBLE_EVT_GATT_CONNECT_IND:
            DBG_PRINTF("CYBLE_EVT_GATT_CONNECT_IND: %x, %x \r\n", 
                (*(CYBLE_CONN_HANDLE_T *)eventParam).attId, 
                (*(CYBLE_CONN_HANDLE_T *)eventParam).bdHandle);
            break;
        case CYBLE_EVT_GATT_DISCONNECT_IND:
            DBG_PRINTF("CYBLE_EVT_GATT_DISCONNECT_IND \r\n");
            break;

        case CYBLE_EVT_GATTS_READ_CHAR_VAL_ACCESS_REQ:
            /* Triggered on server side when client sends read request and when
            * characteristic has CYBLE_GATT_DB_ATTR_CHAR_VAL_RD_EVENT property set.
            * This event could be ignored by application unless it need to response
            * by error response which needs to be set in gattErrorCode field of
            * event parameter. */
            DBG_PRINTF("CYBLE_EVT_GATTS_READ_CHAR_VAL_ACCESS_REQ: handle: %x \r\n", 
                ((CYBLE_GATTS_CHAR_VAL_READ_REQ_T *)eventParam)->attrHandle);
            break;

        /**********************************************************
        *                       Other Events
        ***********************************************************/
        case CYBLE_EVT_PENDING_FLASH_WRITE:
            /* Inform application that flash write is pending. Stack internal data 
            * structures are modified and require to be stored in Flash using 
            * CyBle_StoreBondingData() */
            DBG_PRINTF("CYBLE_EVT_PENDING_FLASH_WRITE\r\n");
            break;

        default:
            DBG_PRINTF("OTHER event: %lx \r\n", event);
			break;
	}
}


void HandleLeds()
{
    static uint32 ledTimer = LED_TIMEOUT;
    static uint8 led = LED_OFF;
    
   /* Blink blue LED to indicate that device advertises */
    if(CyBle_GetState() == CYBLE_STATE_ADVERTISING)
    {
        if(--ledTimer == 0u) 
        {
            ledTimer = LED_TIMEOUT;
            led ^= LED_OFF;
            Advertising_LED_Write(led);
        }
    }
}


/*******************************************************************************
* Function Name: LowPowerImplementation()
********************************************************************************
* Summary:
* Implements low power in the project.
*
* Parameters:
* None
*
* Return:
* None
*
* Theory:
* The function tries to enter deep sleep as much as possible - whenever the 
* BLE is idle and the UART transmission/reception is not happening. At all other
* times, the function tries to enter CPU sleep.
*
*******************************************************************************/
static void LowPowerImplementation(void)
{
    CYBLE_LP_MODE_T bleMode;
    uint8 interruptStatus;
    
    /* For advertising and connected states, implement deep sleep 
     * functionality to achieve low power in the system. For more details
     * on the low power implementation, refer to the Low Power Application 
     * Note.
     */
    if((CyBle_GetState() == CYBLE_STATE_ADVERTISING) || 
       (CyBle_GetState() == CYBLE_STATE_CONNECTED))
    {
        /* Request BLE subsystem to enter into Deep-Sleep mode between connection and advertising intervals */
        bleMode = CyBle_EnterLPM(CYBLE_BLESS_DEEPSLEEP);
        /* Disable global interrupts */
        interruptStatus = CyEnterCriticalSection();
        /* When BLE subsystem has been put into Deep-Sleep mode */
        if(bleMode == CYBLE_BLESS_DEEPSLEEP)
        {
            /* And it is still there or ECO is on */
            if((CyBle_GetBleSsState() == CYBLE_BLESS_STATE_ECO_ON) || 
               (CyBle_GetBleSsState() == CYBLE_BLESS_STATE_DEEPSLEEP))
            {
            #if (DEBUG_UART_ENABLED == ENABLED)
                /* Put the CPU into the Deep-Sleep mode when all debug information has been sent */
                if((UART_DEB_SpiUartGetTxBufferSize() + UART_DEB_GET_TX_FIFO_SR_VALID) == 0u)
                {
                    CySysPmDeepSleep();
                }
                else /* Put the CPU into Sleep mode and let SCB to continue sending debug data */
                {
                    CySysPmSleep();
                }
            #else
                CySysPmDeepSleep();
            #endif /* (DEBUG_UART_ENABLED == ENABLED) */
            }
            HandleLeds();
        }
        else /* When BLE subsystem has been put into Sleep mode or is active */
        {
            /* And hardware doesn't finish Tx/Rx opeation - put the CPU into Sleep mode */
            if(CyBle_GetBleSsState() != CYBLE_BLESS_STATE_EVENT_CLOSE)
            {
                CySysPmSleep();
            }
        }
        /* Enable global interrupt */
        CyExitCriticalSection(interruptStatus);
    }
}


/*******************************************************************************
* Function Name: main()
********************************************************************************
* Summary:
*  Main function for the project.
*
* Parameters:
*  None
*
* Return:
*  None
*
* Theory:
*  The function starts BLE and UART components.
*  This function process all BLE events and also implements the low power 
*  functionality.
*
*******************************************************************************/
int main()
{
    CYBLE_API_RESULT_T apiResult;

    CyGlobalIntEnable;  
    
#if (DEBUG_UART_ENABLED == ENABLED)
	UART_DEB_Start();
#endif /* (DEBUG_UART_ENABLED == ENABLED) */
    DBG_PRINTF("BLE Battery Level Example Project \r\n");

    Disconnect_LED_Write(LED_OFF);
    Advertising_LED_Write(LED_OFF);
    LowPower_LED_Write(LED_OFF);

    CyBle_Start(AppCallBack);
    CyBle_BasRegisterAttrCallback(BasCallBack);
    
	ADC_Start();

	while(1) 
    {              
        /* Process all the generated events. */
        CyBle_ProcessEvents();

        /* To achieve low power in the device */
        LowPowerImplementation();

        /***********************************************************************
        * Wait for connection established with Central device
        ***********************************************************************/
        if(CyBle_GetState() == CYBLE_STATE_CONNECTED)
        {
            /*******************************************************************
            *  Periodically simulate Battery level charging.
            *******************************************************************/        
            SimulateBattery();
            CyBle_ProcessEvents();

            MeasureBattery(); 
        }
        
    #if(CYBLE_BONDING_REQUIREMENT == CYBLE_BONDING_YES)
        /* Store bonding data to flash only when all debug information has been sent */
        #if (DEBUG_UART_ENABLED == ENABLED)
            if((cyBle_pendingFlashWrite != 0u) &&
               ((UART_DEB_SpiUartGetTxBufferSize() + UART_DEB_GET_TX_FIFO_SR_VALID) == 0u))
        #else
            if(cyBle_pendingFlashWrite != 0u)
        #endif /* (DEBUG_UART_ENABLED == ENABLED) */
        {
            apiResult = CyBle_StoreBondingData(0u);
            DBG_PRINTF("Store bonding data, status: %x \r\n", apiResult);
        }
    #endif /* (CYBLE_BONDING_REQUIREMENT == CYBLE_BONDING_YES) */
	}   
}  


/* [] END OF FILE */
