Xylons/TFG_Francisco_de_la_Mata/(commit log)

2020-03-21 Comienzo de la estructura de web Angular con sus dependencias
2020-03-25 Creada la estructura basica, angular, node js con express y mongodb en localhost
2020-04-01 Anadido funcion de borrar editar y anadir fotos siguiendo reactive approach
2020-04-10 anadido control de errores y modularidad
2020-04-11 formada la base del proyecto con optimizaciones de codigo
2020-04-15 anadida barra de navegacion responsive, lateral
2020-05-16 anadido reset de contraseña
2020-05-26 anadido snackbar en recuperacion de password
2020-06-04 anadido perfil basico, a falta de anadir los perfiles especiales
2020-06-22 anadidas las funcionalidades de los roles, edicion de perfiles,api pernalizada para extraer usuarios segun tipo y administracion
2020-06-23 solucion de errores en perfiles, anadido componente dialog y snackbar para mostrar feedback
2020-06-23 arreglado estilo de dialog
2020-06-24 ACTUALIZADAS LIBRERIAS y problemas de versiones
2020-06-26 mejorado diseño de la web y cambiado el diseño de profile-list
    [LeftData2019.09.02.22.26.32.csv]
2020-07-01 version inicial de barra de busqueda
2020-07-03 anadidos valores de busqueda en back y se barra de busqueda flotante
2020-07-06 los fitros de busqueda se extraen personalizados y anadida funcionalidad de anadir paciente a responsable
2020-07-11 anadidos elementos en dashboard, sentencias de back que sirven a dashboard y lectura de ficheros csv
2020-07-12 anadidos botones para seleccionar rangos de fechas
2020-07-13 anadida api para recepcion de datos y decodificacion, y anadidos label para graficar la info individual en dashboard
    [csvFILE.csv]
2020-07-15 anadido servicio para almacenar informacion a la aplicacion android, en proceso anadir comparativa de pacientes en dashboard
    [Insole_PCB-B.Cu.dxf, Insole_PCB-B.Mask.dxf, Insole_PCB-B.SilkS.dxf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]
2020-07-16 modificados los tipos de Documents para almacenar plantilla por hora y por dia
2020-07-16 modificadas las llamadas de dashbard en back y front
2020-07-21 cambios esteticos y actualizados campos de perfil de paciente
2020-07-26 anadido logo y cambios de diseño
2020-07-27 cambios de nombre
2020-07-27 anadida vista de dashboard
2020-09-02 Subidos cambios previos, y preparación para hacer publico el repositorio
    [1594677600000-3-1234.csv, 1594677600000-4-1234.csv, 1594691972000csvFILE2.csv, NaNcsvFILE2.csv]
2020-09-03 optimizacion de compare
2020-09-22 Anadidos datos de la bd
